OrBerebi/Logots_V2/knowledge/functions/initiation.md

# initiation

MAIN GOAL — you are running the function "initiation": this robot has no
memory yet. Meet the plant in front of you for the first time: classify it and
deliver the information that initiates the memory documents. Success = finish
carrying a classification you actually saw (medium or high confidence), or an
honest report of why it was not possible. HOW to get there — when to look,
when to move, when to stop — is entirely your decision; the ACTIONS list tells
you what each tool does.
