OrBerebi/Logots_V2/docs/robot1_system/header_pinouts.png

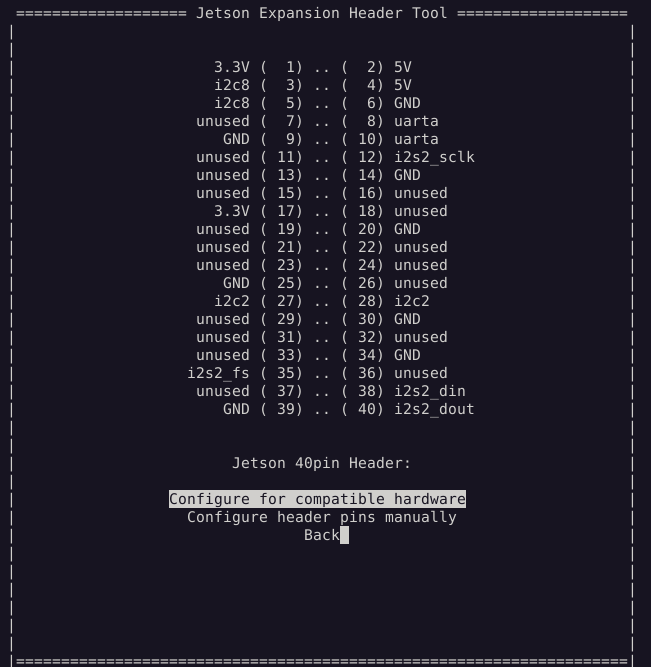
docs/robot1_system/header_pinouts.png
