OrBerebi/Logots_V2/src/logots_ui.py

#!/usr/bin/env python3
"""
Logots Robot Control — Full Monitoring GUI
Panels: Drive + Arm  |  IMU orientation  |  Audio waveform  |  Video feed
"""

import tkinter as tk
from tkinter import filedialog, messagebox
import atexit
import math
import signal
import sys
import time
import threading
import subprocess
import os
import tempfile
import csv
import queue
import json
import collections
import io
import base64
import struct
from datetime import datetime
from http.server import BaseHTTPRequestHandler, ThreadingHTTPServer

# Base64 color JPEG fields exceed the default 128 KB csv field limit
csv.field_size_limit(min(sys.maxsize, 2**31 - 1))

import numpy as np

import matplotlib
matplotlib.use('TkAgg')
from matplotlib.figure import Figure
from matplotlib.backends.backend_tkagg import FigureCanvasTkAgg
from mpl_toolkits.mplot3d.art3d import Poly3DCollection

# ── Optional deps ─────────────────────────────────────────────────────────────
try:
    from smbus2 import SMBus, i2c_msg
    SMBUS2 = True
except ImportError:
    try:
        import smbus
        SMBUS2 = False
    except ImportError:
        SMBUS2 = None

try:
    import sounddevice as sd
    AUDIO_OK = True
except ImportError:
    AUDIO_OK = False


from PIL import Image, ImageTk

try:
    import cv2
    CV2_OK = True
except ImportError:
    CV2_OK = False

# ── Hardware constants ────────────────────────────────────────────────────────
API_PORT      = 8787
ARDUINO_ADDR  = 0x08
ENC_PKT_HDR   = 0xE5   # encoder read-back packet: hdr, int32 left, int32 right, sum8
ENC_PKT_LEN   = 10     # (see requestEvent() in the firmware)
IMU_I2C_BUS   = 7
MPU_ADDR      = 0x68
AUDIO_RATE    = 16000
AUDIO_BLOCK   = 512

# ── Capture loop rate ─────────────────────────────────────────────────────────
# Sensory-capture / recording tick rate. The loop is drift-compensated (it waits
# PERIOD_MS minus however long the tick's work took), so the ACTUAL rate tracks
# TARGET_FPS as long as the per-tick work fits inside PERIOD_MS. 10 FPS (100 ms)
# is sustainable on the Jetson, whose per-tick work is ~45-90 ms.
TARGET_FPS = 10
PERIOD_MS  = int(round(1000 / TARGET_FPS))   # 100 ms per tick

# Camera capture rate. The FIFO reader keeps only the latest frame, so the camera
# only needs to feed the ~10 FPS loop — running it at the sensor's full 30 FPS just
# burns ISP + videoconvert + FIFO bandwidth on frames that get discarded. A little
# headroom above TARGET_FPS keeps the displayed frame fresh. Drop to match if you
# want maximum savings.
CAMERA_FPS = 15

PWR_MGMT_1 = 0x6B;  CONFIG_REG = 0x1A
GYRO_CFG   = 0x1B;  ACCEL_CFG  = 0x1C;  ACCEL_CFG2 = 0x1D
ACCEL_OUT  = 0x3B;  GYRO_OUT   = 0x43
ACCEL_SCALE = 16384.0;  GYRO_SCALE = 131.0

# ── Position estimation ───────────────────────────────────────────────────────
# Primary model (2026-10-03): per-tick forward distance comes from real encoder counts
# (JGA25-370 Hall encoders), not a PWM model — see PositionEstimator below. Direction still
# comes from the IMU yaw (no encoder-based heading — the two wheels' counts-per-rev already
# differ by ~2%, not reliable enough for differential heading on top of the IMU we already
# have). counts-per-rev and wheel diameter are from the 2026-10-03 bench test (5 hand-turns
# per wheel; wheel diameter measured at 2.78in outer).
LEFT_COUNTS_PER_REV  = 3286
RIGHT_COUNTS_PER_REV = 3208
WHEEL_DIAMETER_M      = 2.78 * 0.0254   # = 0.0706 m
WHEEL_CIRCUMFERENCE_M = math.pi * WHEEL_DIAMETER_M

# Fallback model, used only on a tick where the encoder read-back fails (see
# PositionEstimator.update()) — forward speed modelled as proportional to commanded average
# PWM. ROBOT_MAX_SPEED_MPS is still an uncalibrated GUESS; fine for the rare fallback tick,
# not a substitute for the encoder path above.
ROBOT_MAX_SPEED_MPS = 0.30            # forward speed at |PWM|=255 — GUESS, calibrate
K_V = ROBOT_MAX_SPEED_MPS / 255.0     # m/s per PWM unit

# Gyro-assisted straight-line trim (2026-10-03): live floor tests found the robot curves
# ~5-6°/s even at equal left_pwm=right_pwm, despite the two motors measuring roughly
# speed-matched on the (unloaded, wheels-raised) bench test — a real floor-load asymmetry.
# _send_motors() corrects this in software: whenever the commanded PWM is equal and
# nonzero, it locks the IMU yaw at that moment and trims one wheel proportionally to the
# yaw error each tick, on the wire only (self.left_pwm/right_pwm — the commanded intent used
# by PositionEstimator's PWM fallback, the CSV and the frame API — are untouched). The sign
# below (left wheel reduced / right increased for positive error) is a first guess from the
# 2026-10-03 curving direction (right wheel's path measured longer than left's — see
# CLAUDE.md) — if a straight-drive test still curves, or curves the other way, flip the sign
# in _straight_trim().
STRAIGHT_KP       = 3.0   # PWM counts of trim per degree of yaw error. Live-tested 2026-10-03:
                           # KP=3 cut drift from ~5.6°/s (uncorrected) to ~1.4°/s, reproduced
                           # twice. KP=6 was tried to tighten it further and instead went
                           # unstable (133° drift in 4s, worse than uncorrected) — reverted.
                           # Don't raise this without adding tick-by-tick error/trim logging
                           # first to see the oscillation (the IMU may also be noisier while
                           # actually driving — motor electrical noise/vibration — than at rest,
                           # which a higher P gain would amplify).
STRAIGHT_KI       = 0.4   # PWM counts of trim per (degree·second) of accumulated error —
                           # added 2026-10-03 to kill the P-only controller's steady-state
                           # residual (observed: robot visibly not quite straight, right wheel
                           # slightly ahead) without raising KP again.
STRAIGHT_I_MAX    = 40     # anti-windup clamp on the accumulated integral's contribution
STRAIGHT_MAX_TRIM = 60    # clamp, so a large transient error can't stall/reverse a wheel

# ── Palette ───────────────────────────────────────────────────────────────────
C_BG      = '#1e1e2e'
C_PANEL   = '#2a2a3e'
C_BORDER  = '#3a3a5a'
C_TEXT    = '#e0e0f0'
C_SUB     = '#7070a0'
C_BLUE    = '#1a7abf'
C_BLUE_HI = '#3498db'
C_GREEN   = '#27ae60'
C_RED     = '#c0392b'
C_AMBER   = '#e67e22'

# ── Madgwick AHRS ─────────────────────────────────────────────────────────────
class Madgwick:
    def __init__(self, beta=0.033):
        self.beta = beta
        self.q    = np.array([1.0, 0.0, 0.0, 0.0])

    def update_imu(self, gx, gy, gz, ax, ay, az, dt):
        q = self.q
        gx=math.radians(gx); gy=math.radians(gy); gz=math.radians(gz)
        norm=math.sqrt(ax*ax+ay*ay+az*az)
        if norm==0: return
        ax/=norm; ay/=norm; az/=norm
        _2q0=2*q[0];_2q1=2*q[1];_2q2=2*q[2];_2q3=2*q[3]
        _4q0=4*q[0];_4q1=4*q[1];_4q2=4*q[2];_8q1=8*q[1];_8q2=8*q[2]
        q0q0=q[0]*q[0];q1q1=q[1]*q[1];q2q2=q[2]*q[2];q3q3=q[3]*q[3]
        s0=_4q0*q2q2+_2q2*ax+_4q0*q1q1-_2q1*ay
        s1=_4q1*q3q3-_2q3*ax+4*q0q0*q[1]-_2q0*ay-_4q1+_8q1*q1q1+_8q1*q2q2+_4q1*az
        s2=4*q0q0*q[2]+_2q0*ax+_4q2*q3q3-_2q3*ay-_4q2+_8q2*q1q1+_8q2*q2q2+_4q2*az
        s3=4*q1q1*q[3]-_2q1*ax+4*q2q2*q[3]-_2q2*ay
        norm=math.sqrt(s0*s0+s1*s1+s2*s2+s3*s3)
        if norm>0: s0/=norm;s1/=norm;s2/=norm;s3/=norm
        qD0=0.5*(-q[1]*gx-q[2]*gy-q[3]*gz)-self.beta*s0
        qD1=0.5*( q[0]*gx+q[2]*gz-q[3]*gy)-self.beta*s1
        qD2=0.5*( q[0]*gy-q[1]*gz+q[3]*gx)-self.beta*s2
        qD3=0.5*( q[0]*gz+q[1]*gy-q[2]*gx)-self.beta*s3
        q[0]+=qD0*dt;q[1]+=qD1*dt;q[2]+=qD2*dt;q[3]+=qD3*dt
        self.q=q/math.sqrt(sum(x*x for x in q))

    def get_yaw_pitch_roll(self):
        q=self.q
        yaw  =math.degrees(math.atan2(2*(q[0]*q[3]+q[1]*q[2]),1-2*(q[2]*q[2]+q[3]*q[3])))
        pitch=math.degrees(math.asin(max(-1,min(1,2*(q[0]*q[2]-q[3]*q[1])))))
        roll =math.degrees(math.atan2(2*(q[0]*q[1]+q[2]*q[3]),1-2*(q[1]*q[1]+q[2]*q[2])))
        return yaw, pitch, roll

# ── IMU reader thread ─────────────────────────────────────────────────────────
class IMUReader(threading.Thread):
    CAL_N = 500

    def __init__(self):
        super().__init__(daemon=True)
        self.roll=self.pitch=self.yaw=0.0
        self.status      = 'starting'
        self.cal_prog    = 0
        self._stop       = threading.Event()
        self._bus        = None
        self._sample_buf  = []
        self._sample_lock = threading.Lock()

    def stop(self): self._stop.set()

    def drain_samples(self):
        with self._sample_lock:
            out, self._sample_buf = self._sample_buf, []
        return out

    def run(self):
        try:
            self._init_hw()
            self._calibrate()
            self.status = 'running'
            filt=Madgwick(); t_prev=time.time()
            while not self._stop.is_set():
                ax,ay,az=self._accel()
                gx,gy,gz=self._gyro()
                gx-=self._bg[0]; gy-=self._bg[1]; gz-=self._bg[2]
                t=time.time(); dt=t-t_prev; t_prev=t
                filt.update_imu(gx,gy,gz,ax,ay,az,dt)
                yaw,pitch,roll=filt.get_yaw_pitch_roll()
                yaw-=self._yo; pitch-=self._po; roll-=self._ro
                yaw=math.fmod(yaw+360,360)
                if pitch>180: pitch-=360
                if pitch<-180: pitch+=360
                if roll>180: roll-=360
                if roll<-180: roll+=360
                self.yaw=yaw; self.pitch=pitch; self.roll=roll
                with self._sample_lock:
                    self._sample_buf.append((yaw, pitch, roll))
                time.sleep(0.005)   # cap ~200Hz (2026-10-03) — this loop had no rate limit at
                # all, spinning as fast as the I2C bus allowed (likely 1000s of Hz) and
                # pegging a CPU core continuously; under the GIL that starves the main GUI
                # thread of scheduling time, which is why the capture tick's actual FPS was
                # sitting well under its 10Hz target even at rest. 200Hz is still far faster
                # than anything downstream needs (the 10Hz capture tick just drains whatever
                # accumulated; the Madgwick filter integrates fine at this rate).
        except Exception as e:
            self.status=f'error: {e}'

    def _init_hw(self):
        b = SMBus(IMU_I2C_BUS) if SMBUS2 else smbus.SMBus(IMU_I2C_BUS)
        self._bus=b
        b.write_byte_data(MPU_ADDR,PWR_MGMT_1,0x00); time.sleep(0.1)
        b.write_byte_data(MPU_ADDR,PWR_MGMT_1,0x01)
        b.write_byte_data(MPU_ADDR,CONFIG_REG, 0x02)
        b.write_byte_data(MPU_ADDR,ACCEL_CFG,  0x00)
        b.write_byte_data(MPU_ADDR,ACCEL_CFG2, 0x04)
        b.write_byte_data(MPU_ADDR,GYRO_CFG,   0x00)
        time.sleep(0.1)

    def _calibrate(self):
        self.status='calibrating'
        N=self.CAL_N
        sx=sy=sz=0.0
        for i in range(N):
            gx,gy,gz=self._gyro(); sx+=gx; sy+=gy; sz+=gz
            self.cal_prog=int(i/N*50)
        self._bg=(sx/N,sy/N,sz/N)
        filt=Madgwick(); t_prev=time.time()
        sy2=sp2=sr2=0.0
        for i in range(N):
            ax,ay,az=self._accel(); gx,gy,gz=self._gyro()
            gx-=self._bg[0]; gy-=self._bg[1]; gz-=self._bg[2]
            t=time.time(); filt.update_imu(gx,gy,gz,ax,ay,az,t-t_prev); t_prev=t
            y,p,r=filt.get_yaw_pitch_roll(); sy2+=y; sp2+=p; sr2+=r
            self.cal_prog=50+int(i/N*50)
        self._yo=sy2/N; self._po=sp2/N; self._ro=sr2/N

    def _s16(self,hi,lo):
        v=(hi<<8)|lo; return v-65536 if v>32767 else v

    def _accel(self):
        d=self._bus.read_i2c_block_data(MPU_ADDR,ACCEL_OUT,6)
        return (self._s16(d[0],d[1])/ACCEL_SCALE,
                self._s16(d[2],d[3])/ACCEL_SCALE,
                self._s16(d[4],d[5])/ACCEL_SCALE)

    def _gyro(self):
        d=self._bus.read_i2c_block_data(MPU_ADDR,GYRO_OUT,6)
        return (self._s16(d[0],d[1])/GYRO_SCALE,
                self._s16(d[2],d[3])/GYRO_SCALE,
                self._s16(d[4],d[5])/GYRO_SCALE)

# ── Position estimator ────────────────────────────────────────────────────────
class PositionEstimator:
    """Dead-reckons body (x, y) in metres from wheel encoders + IMU heading.

    Forward distance per tick is the average of each wheel's measured displacement
    (encoder count delta / that wheel's counts-per-rev · wheel circumference); heading θ
    comes from the IMU yaw, not the encoders (the two wheels' counts-per-rev already differ
    by ~2%, not precise enough for differential heading on top of the IMU we already have).
    Integrated each tick: x += d·cosθ, y += d·sinθ. Pure spins (L=+, R=−) average to ~0 net
    wheel displacement, so heading changes without translation.

    Falls back to the old PWM-speed model (v = k_v·(left_pwm+right_pwm)/2, integrated over
    dt) for any tick where the encoder read-back fails (enc_left/enc_right is None) — e.g. a
    bad I2C read. Once readings resume, the encoder delta is computed against the last good
    count, so no distance is lost across a brief gap; only that one tick's distance comes
    from the (less accurate) PWM model instead of being skipped outright."""

    def __init__(self, k_v=K_V,
                 left_counts_per_rev=LEFT_COUNTS_PER_REV,
                 right_counts_per_rev=RIGHT_COUNTS_PER_REV,
                 wheel_circumference_m=WHEEL_CIRCUMFERENCE_M):
        self.k_v = k_v
        self.left_counts_per_rev    = left_counts_per_rev
        self.right_counts_per_rev   = right_counts_per_rev
        self.wheel_circumference_m  = wheel_circumference_m
        self.reset()

    def reset(self):
        self.x = self.y = self.heading = 0.0
        self._t = None
        self._last_enc_left = self._last_enc_right = None

    def update(self, enc_left, enc_right, left_pwm, right_pwm, yaw_deg, now=None):
        now = now if now is not None else time.monotonic()
        have_enc = enc_left is not None and enc_right is not None
        if self._t is None:                 # first sample: seed time + heading only
            self._t = now; self.heading = yaw_deg
            if have_enc: self._last_enc_left, self._last_enc_right = enc_left, enc_right
            return
        dt = now - self._t; self._t = now
        if dt <= 0 or dt > 0.5: return      # guard stalls / first big gap
        if have_enc and self._last_enc_left is not None:
            dist_l = ((enc_left  - self._last_enc_left)  / self.left_counts_per_rev
                       * self.wheel_circumference_m)
            dist_r = ((enc_right - self._last_enc_right) / self.right_counts_per_rev
                       * self.wheel_circumference_m)
            forward = (dist_l + dist_r) / 2.0
        else:                                # encoder read failed this tick: PWM fallback
            forward = self.k_v * (left_pwm + right_pwm) / 2.0 * dt
        if have_enc:
            self._last_enc_left, self._last_enc_right = enc_left, enc_right
        th = math.radians(yaw_deg)
        self.x += forward * math.cos(th)
        self.y += forward * math.sin(th)
        self.heading = yaw_deg

# ── Audio reader ──────────────────────────────────────────────────────────────
class AudioReader:
    def __init__(self):
        self._stream   = None
        self.status    = 'stopped'
        self._drain_buf  = []
        self._drain_lock = threading.Lock()

    def start(self):
        if not AUDIO_OK:
            self.status='unavailable'; return
        try:
            self._stream=sd.InputStream(samplerate=AUDIO_RATE,channels=1,
                                         blocksize=AUDIO_BLOCK,callback=self._cb)
            self._stream.start(); self.status='running'
        except Exception as e:
            self.status=f'error: {e}'

    def _cb(self,indata,frames,t,status):
        with self._drain_lock:
            self._drain_buf.extend(indata[:, 0].tolist())

    def drain_samples(self):
        with self._drain_lock:
            out, self._drain_buf = self._drain_buf, []
        return out

    def stop(self):
        if self._stream:
            try: self._stream.stop(); self._stream.close()
            except: pass

# ── Action reader (executes functions-layer decisions from :8788) ──────────────
class ActionReader(threading.Thread):
    """Ask #3 in docs/v2_architecture/functions_layer_report.md: polls Asaf's
    functions-layer ActionsEndpoint (GET :8788/latest_action, src/actions.py)
    and executes approach_plant's left_pwm/right_pwm/duration_s on the motors,
    the same way the joystick does (sets gui.left_pwm/right_pwm; _send_motors()
    ticks them out over I2C). Completion (ask #2) is reported back over the
    real contract actions.py already implements — POST :8788/action_done with
    {"action_id", "pos_x", "pos_y", "heading"} — which is what functions.py's
    wait_for_done()/endpoint.completion() actually waits on (NOT the :8787
    frame API; an earlier version of this reader used a `last_action_id` field
    there, but that doesn't satisfy the contract actions.py implements)."""

    POLL_S = 0.2

    def __init__(self, gui, host='localhost', port=8788):
        super().__init__(daemon=True)
        self.gui   = gui
        self.host  = host
        self.port  = port
        self.get_url  = f'http://{host}:{port}/latest_action'
        self.post_url = f'http://{host}:{port}/action_done'
        self._stop_evt = threading.Event()
        self._seen_id  = None

    def stop(self):
        self._stop_evt.set()

    def run(self):
        import urllib.request
        while not self._stop_evt.is_set():
            time.sleep(self.POLL_S)
            try:
                with urllib.request.urlopen(self.get_url, timeout=1.0) as resp:
                    action = json.loads(resp.read())
            except Exception:
                continue  # functions.py not running yet, or no action published yet
            aid = action.get('action_id')
            if aid is None or aid == self._seen_id:
                continue
            self._seen_id = aid
            if action.get('action') == 'approach_plant' and not self.gui.sim_mode:
                self._drive(action)

    def _drive(self, action):
        import urllib.request
        args = action.get('args', {})
        try:
            l   = max(-255, min(255, int(args['left_pwm'])))
            r   = max(-255, min(255, int(args['right_pwm'])))
            dur = max(0.0, float(args['duration_s']))
        except (KeyError, TypeError, ValueError) as e:
            print(f"[actions] bad approach_plant args {args}: {e}", flush=True)
            return
        aid = action['action_id']
        print(f"[actions] approach_plant #{aid} L={l} R={r} for {dur}s", flush=True)
        self.gui.left_pwm, self.gui.right_pwm = l, r
        time.sleep(dur)
        self.gui.left_pwm = self.gui.right_pwm = 0
        pos = self.gui._pos_est
        report = {'action_id': aid, 'pos_x': pos.x, 'pos_y': pos.y, 'heading': pos.heading}
        try:
            req = urllib.request.Request(self.post_url, data=json.dumps(report).encode(),
                                         headers={'Content-Type': 'application/json'}, method='POST')
            urllib.request.urlopen(req, timeout=1.0).close()
            print(f"[actions] approach_plant #{aid} done, reported pos "
                  f"({pos.x:.2f}, {pos.y:.2f}) heading {pos.heading:.0f}°", flush=True)
        except Exception as e:
            print(f"[actions] failed to POST /action_done for #{aid}: {e}", flush=True)

# ── Listener status (what functions.py --listen is doing, from :8788/status) ───
class ListenerStatusReader(threading.Thread):
    """Polls the voice listener's GET :8788/status for the header's LLM/MIC
    indicators and the audio panel's ACTION row. Its own thread: ActionReader
    sleeps through every drive, and the capture tick must never wait on HTTP."""

    POLL_S = 0.2

    def __init__(self, host='localhost', port=8788):
        super().__init__(daemon=True)
        self.url = f'http://{host}:{port}/status'
        self.stage = 'off'       # 'off' = nothing answering on :8788
        self.last_action = None

    def run(self):
        import urllib.request
        while True:
            try:
                with urllib.request.urlopen(self.url, timeout=1.0) as resp:
                    status = json.loads(resp.read())
                self.stage = status.get('stage', 'off')
                self.last_action = status.get('last_action') or self.last_action
            except Exception:
                self.stage = 'off'
            time.sleep(self.POLL_S)

# ── Camera reader ─────────────────────────────────────────────────────────────
class CameraReader(threading.Thread):
    W, H = 640, 480
    FRAME_BYTES = W * H * 3

    def __init__(self):
        super().__init__(daemon=True)
        self._frame = None
        self._lock  = threading.Lock()
        self.status = 'starting'
        self._stop  = threading.Event()
        self._proc  = None

    def stop(self):
        self._stop.set()
        if self._proc:
            try: self._proc.terminate()
            except: pass

    def get_frame(self):
        with self._lock:
            return self._frame.copy() if self._frame is not None else None

    FIFO = '/tmp/logots_camera.fifo'

    def run(self):
        # Use a FIFO so frame bytes are fully separated from gst-launch text output
        if os.path.exists(self.FIFO):
            os.unlink(self.FIFO)
        os.mkfifo(self.FIFO)

        pipeline = (
            f'nvarguscamerasrc sensor-id=0 '
            f'! "video/x-raw(memory:NVMM),width={self.W},height={self.H},framerate={CAMERA_FPS}/1" '
            f'! nvvidconv '
            f'! "video/x-raw,format=BGRx" '
            f'! videoconvert '
            f'! "video/x-raw,format=BGR" '
            f'! filesink location={self.FIFO}'
        )
        env = os.environ.copy()
        env['EGL_PLATFORM'] = 'surfaceless'
        try:
            self._proc = subprocess.Popen(
                f'gst-launch-1.0 -q {pipeline}',
                shell=True, stdout=subprocess.DEVNULL, stderr=subprocess.DEVNULL,
                env=env
            )
            with open(self.FIFO, 'rb') as fifo:
                self.status = 'running'
                while not self._stop.is_set():
                    raw = fifo.read(self.FRAME_BYTES)
                    if len(raw) != self.FRAME_BYTES:
                        break
                    frame = np.frombuffer(raw, dtype=np.uint8).reshape(self.H, self.W, 3)
                    with self._lock:
                        self._frame = frame
        except Exception as e:
            self.status = f'error: {e}'
            return
        self.status = 'stopped'

# ── 3-D board geometry ────────────────────────────────────────────────────────
_BV = np.array([[-0.8,-1.5,-0.1],[0.8,-1.5,-0.1],[0.8,1.5,-0.1],[-0.8,1.5,-0.1],
                [-0.8,-1.5, 0.1],[0.8,-1.5, 0.1],[0.8,1.5, 0.1],[-0.8,1.5, 0.1]])
_BF = [[0,1,2,3],[4,5,6,7],[4,5,1,0],[6,7,3,2],[0,3,7,4],[1,2,6,5]]
_FC = [C_BLUE,C_BLUE,C_GREEN,C_GREEN,C_RED,C_RED]

def _rotmat(r,p,y):
    r=math.radians(r); p=math.radians(p); y=math.radians(y)
    Rx=np.array([[1,0,0],[0,math.cos(r),-math.sin(r)],[0,math.sin(r),math.cos(r)]])
    Ry=np.array([[math.cos(p),0,math.sin(p)],[0,1,0],[-math.sin(p),0,math.cos(p)]])
    Rz=np.array([[math.cos(y),-math.sin(y),0],[math.sin(y),math.cos(y),0],[0,0,1]])
    return Rz@Ry@Rx

# ── Frame encoding ────────────────────────────────────────────────────────────
def _encode_frame(frame_bgr):
    """BGR numpy (H×W×3) → color 640×640 JPEG base64 string."""
    img = Image.fromarray(frame_bgr[:, :, ::-1])
    img = img.resize((640, 640), Image.LANCZOS)
    buf = io.BytesIO()
    img.save(buf, format='JPEG', quality=70)
    return base64.b64encode(buf.getvalue()).decode('utf-8')

def _decode_frame(b64):
    """base64 JPEG string → BGR numpy (H×W×3), or None if empty.
    Handles both old grayscale and new color recordings."""
    if not b64:
        return None
    img = Image.open(io.BytesIO(base64.b64decode(b64))).convert('RGB')
    return np.asarray(img)[:, :, ::-1]

# ── Recording manager ─────────────────────────────────────────────────────────
class RecordingManager:
    # Original columns — the minimal set required for a CSV to count as a Logots
    # recording (SimPlayer checks against this so pre-position recordings still load).
    CORE_FIELDNAMES = [
        'frame_id', 'timestamp', 'frame_data',
        'yaw', 'pitch', 'roll',
        'audio_samples',
        'left_pwm', 'right_pwm', 'pan_angle', 'tilt_angle',
    ]
    # pos_x/pos_y (metres) + heading (deg): dead-reckoning estimate, see PositionEstimator.
    FIELDNAMES = CORE_FIELDNAMES + ['pos_x', 'pos_y', 'heading']

    def __init__(self):
        self._active   = False
        self._queue    = queue.Queue(maxsize=300)
        self._thread   = None
        self._csv_path = None

    @property
    def active(self): return self._active

    def start(self):
        ts = datetime.now().strftime('%Y%m%d_%H%M%S')
        _repo = os.path.dirname(os.path.dirname(os.path.abspath(__file__)))
        out_dir = os.path.join(_repo, 'recordings', f'session_{ts}')
        os.makedirs(out_dir, exist_ok=True)
        self._csv_path = os.path.join(out_dir, f'session_{ts}.csv')
        self._active = True
        self._thread = threading.Thread(target=self._writer, daemon=True)
        self._thread.start()

    def stop(self):
        self._active = False
        self._queue.put(None)
        if self._thread:
            self._thread.join(timeout=15)

    def enqueue(self, frame: dict, frame_bgr):
        if not self._active: return
        try:
            self._queue.put_nowait((dict(frame), frame_bgr))
        except queue.Full:
            pass

    def _writer(self):
        with open(self._csv_path, 'w', newline='') as f:
            w = csv.DictWriter(f, fieldnames=self.FIELDNAMES)
            w.writeheader()
            while True:
                item = self._queue.get()
                if item is None:
                    break
                row, frame_bgr = item
                row['frame_data'] = _encode_frame(frame_bgr) if frame_bgr is not None else ''
                w.writerow(row)
                f.flush()

# ── Sim player ────────────────────────────────────────────────────────────────
class SimPlayer:
    """Replays a recorded session CSV row-by-row, paced by its timestamps
    so playback runs in real time regardless of the rate the recording
    actually achieved."""

    WAIT = 'wait'   # sentinel: current frame should be held, next row not due yet

    def __init__(self, csv_path):
        self.csv_path  = csv_path
        self.loop      = True
        self.row_index = 0
        self.n_skipped = 0
        self._pending    = None   # parsed (frame, decoded, bgr) not yet due
        self._pending_ts = None   # its recorded timestamp (datetime or None)
        try:                       # one-time line count for the SIM %-progress readout
            with open(csv_path, 'r', newline='') as f:
                self.total_rows = max(sum(1 for _ in f) - 1, 0)   # minus header
        except OSError:
            self.total_rows = 0
        self._open()

    def _open(self):
        self._file   = open(self.csv_path, 'r', newline='')
        self._reader = csv.DictReader(self._file)
        fields = self._reader.fieldnames or []
        if not set(RecordingManager.CORE_FIELDNAMES) <= set(fields):
            self._file.close()
            raise ValueError('not a Logots recording CSV')
        self.row_index    = 0     # restart the %-progress readout each pass
        self._wall_start = None   # monotonic time when this pass started
        self._rec_start  = None   # first row's recorded timestamp of this pass

    def next_frame(self):
        """Return the next (frame, decoded, frame_bgr) once its recorded
        timestamp is due, SimPlayer.WAIT while the current frame should be
        held, or None at end-of-file when loop is off. Malformed rows are
        skipped; rows without a parsable timestamp are due immediately."""
        if self._pending is None and not self._advance():
            return None
        if self._pending_ts is not None:
            now = time.monotonic()
            if self._wall_start is None:
                self._wall_start = now
                self._rec_start  = self._pending_ts
            due = (self._pending_ts - self._rec_start).total_seconds()
            if now - self._wall_start < due:
                return SimPlayer.WAIT
        out = self._pending
        self._pending = None
        return out

    def _advance(self):
        """Parse the next valid row into self._pending. False at EOF (no loop)."""
        while True:
            try:
                row = next(self._reader)
            except StopIteration:
                if not self.loop:
                    return False
                self._file.close()
                self._open()          # resets this pass's time origins
                continue
            self.row_index += 1
            try:
                self._pending = self._parse(row)
            except Exception:
                self.n_skipped += 1
                continue
            try:
                self._pending_ts = datetime.fromisoformat(self._pending[0]['timestamp'])
            except Exception:
                self._pending_ts = None
            return True

    def _parse(self, row):
        def arr(key):
            try:    return json.loads(row.get(key) or '[]')
            except Exception: return []
        def num(key, fallback):
            try:    return int(float(row.get(key)))
            except Exception: return fallback
        def fnum(key, fallback):            # float variant, for the position columns
            try:    return float(row.get(key))
            except Exception: return fallback
        yaw, pitch, roll = arr('yaw'), arr('pitch'), arr('roll')
        decoded = {
            'imu':        list(zip(yaw, pitch, roll)),
            'audio':      arr('audio_samples'),
            'left_pwm':   num('left_pwm', 0),
            'right_pwm':  num('right_pwm', 0),
            'pan_angle':  num('pan_angle', 0),
            'tilt_angle': num('tilt_angle', 90),
            'pos_x':      fnum('pos_x', 0.0),   # 0.0 when column absent (old CSVs)
            'pos_y':      fnum('pos_y', 0.0),
            'heading':    fnum('heading', 0.0),
        }
        frame = {
            'frame_id':      num('frame_id', self.row_index - 1),
            'timestamp':     row.get('timestamp') or '',
            'frame_data':    row.get('frame_data') or '',
            'yaw':           row.get('yaw') or '[]',
            'pitch':         row.get('pitch') or '[]',
            'roll':          row.get('roll') or '[]',
            'audio_samples': row.get('audio_samples') or '[]',
            'left_pwm':      decoded['left_pwm'],
            'right_pwm':     decoded['right_pwm'],
            'pan_angle':     decoded['pan_angle'],
            'tilt_angle':    decoded['tilt_angle'],
            'pos_x':         decoded['pos_x'],
            'pos_y':         decoded['pos_y'],
            'heading':       decoded['heading'],
        }
        return frame, decoded, _decode_frame(frame['frame_data'])

    def close(self):
        try: self._file.close()
        except Exception: pass

# ── Frame API server ──────────────────────────────────────────────────────────
class FrameServer:
    """Stdlib HTTP server exposing the GUI's latest_frame at GET /latest_frame.
    JPEG encoding for real mode happens lazily per request (cached by frame_id)
    so the 20 Hz tick never pays for it."""

    def __init__(self, gui, host='0.0.0.0', port=API_PORT):
        self.gui    = gui
        self._cache = (None, '')   # (frame_id, base64 jpeg)
        self._server = ThreadingHTTPServer((host, port), self._make_handler())
        threading.Thread(target=self._server.serve_forever, daemon=True).start()

    def _payload(self):
        gui = self.gui
        with gui._frame_lock:
            frame = dict(gui.latest_frame)
            bgr   = gui.latest_frame_bgr
            sim   = gui.sim_mode
        if not frame:
            return None
        if not frame.get('frame_data') and bgr is not None:
            fid, b64 = self._cache
            if fid != frame['frame_id']:
                b64 = _encode_frame(bgr)
                self._cache = (frame['frame_id'], b64)
            frame['frame_data'] = b64
        for k in ('yaw', 'pitch', 'roll', 'audio_samples'):
            try:    frame[k] = json.loads(frame.get(k) or '[]')
            except Exception: frame[k] = []
        frame['sim_mode'] = sim
        return frame

    def _make_handler(server_self):
        class Handler(BaseHTTPRequestHandler):
            def log_message(self, *a): pass
            def _send(self, code, obj):
                body = json.dumps(obj).encode('utf-8')
                self.send_response(code)
                self.send_header('Content-Type', 'application/json')
                self.send_header('Content-Length', str(len(body)))
                self.end_headers()
                self.wfile.write(body)
            def do_GET(self):
                if self.path.split('?')[0] != '/latest_frame':
                    self._send(404, {'error': 'unknown path, use /latest_frame'})
                    return
                try:
                    payload = server_self._payload()
                except Exception as e:
                    self._send(500, {'error': str(e)})
                    return
                if payload is None:
                    self._send(503, {'error': 'no frame yet'})
                else:
                    self._send(200, payload)
        return Handler

# ── Widget helpers ────────────────────────────────────────────────────────────
def _hline(p):
    tk.Frame(p,bg=C_BORDER,height=1).pack(fill='x',padx=16,pady=3)

def _lbl(p,txt,fg=C_SUB,font=('Courier',9),bg=C_BG,**kw):
    return tk.Label(p,text=txt,bg=bg,fg=fg,font=font,**kw)

def _plbl(p,txt,fg=C_SUB,font=('Courier',9),**kw):
    return tk.Label(p,text=txt,bg=C_PANEL,fg=fg,font=font,**kw)

def _vallbl(p,txt,fg=C_BLUE,width=0,**kw):
    kw.setdefault('padx',8); kw.setdefault('pady',4)
    return tk.Label(p,text=txt,bg=C_PANEL,fg=fg,font=('Courier',11,'bold'),
                    width=width,**kw)

def _btn(p,txt,color,cmd,**kw):
    return tk.Button(p,text=txt,bg=color,fg=C_TEXT,relief='flat',
                     font=('Courier',10,'bold'),padx=12,pady=3,command=cmd,
                     cursor='hand2',activebackground=color,activeforeground=C_TEXT,**kw)

# ── Main GUI ──────────────────────────────────────────────────────────────────
class RobotControlGUI:
    JOY_R = 108
    JOY_T = 20

    def __init__(self, root):
        self.root=root
        root.title('Logots — Robot Control')
        root.configure(bg=C_BG)
        root.resizable(False,False)

        self.joy_x=self.joy_y=0.0
        self.joy_dragging=False
        self.keys_held=set()
        self.left_pwm=self.right_pwm=0
        self.pan_angle=0     # -90…+90, 0 = camera facing front, + = left
        self.tilt_angle=90
        self.enc_left=self.enc_right=None   # cumulative encoder counts; None = no reading
        self._straight_target=None   # locked IMU yaw for the gyro straight-line trim, see _straight_trim()
        self._straight_integral=0.0  # accumulated yaw error for the trim's integral term
        self._straight_t=None        # time.monotonic() of the last _straight_trim() call

        self._pos_est   = PositionEstimator()
        self._pos_trail = collections.deque(maxlen=400)  # (x,y) points for the mini-map

        self._fps_ema     = 0.0    # smoothed actual capture rate (Hz)
        self._last_tick_t = None   # monotonic time of the previous tick start

        self.i2c=None; self.connected=False
        self._last_reconnect=0

        self._rec_manager  = RecordingManager()
        self._rec_frame_id = 0
        self.latest_frame     = {}
        self.latest_frame_bgr = None
        self.latest_decoded   = {'imu': [], 'audio': []}
        self._frame_lock      = threading.Lock()
        self._rms_ema         = 0.0

        self.sim_mode   = False
        self.sim_player = None
        self._sim_ended = False
        self._pre_sim_angles = (90, 90)

        self.imu_reader=None; self.audio_reader=None; self.camera_reader=None
        self._imu_poly=None; self._imu_live=False
        self.action_reader=None
        self.listener=None

        self._build_ui()
        self._bind_keys()
        self._start_sensors()
        try:
            self._frame_server = FrameServer(self)
        except Exception as e:
            print(f'[logots] frame API server not started: {e}')
            self._frame_server = None
        self.action_reader = ActionReader(self); self.action_reader.start()
        self.listener_status = ListenerStatusReader(); self.listener_status.start()
        self._start_listener()
        self.root.protocol('WM_DELETE_WINDOW',self._shutdown)
        # via after(): never interrupt a tick mid-I2C-write with the final motor-stop
        signal.signal(signal.SIGTERM,lambda *_: self.root.after(0,self._shutdown))
        self._loop()

    # ── Build UI ──────────────────────────────────────────────────────────────
    def _build_ui(self):
        self._hdr(); _hline(self.root)
        self._main_panels()

    def _hdr(self):
        f=tk.Frame(self.root,bg=C_BG)
        f.pack(fill='x',padx=16,pady=(12,0))
        _lbl(f,'LOGOTS  ROBOT CONTROL',fg=C_TEXT,font=('Courier',14,'bold')).pack(side='left')
        self.lbl_cs=_lbl(f,'⬤  DISCONNECTED',fg=C_RED,font=('Courier',9,'bold'))
        self.lbl_cs.pack(side='right')
        self.lbl_fps=_lbl(f,'FPS: --',fg=C_SUB,font=('Courier',9,'bold'))
        self.lbl_fps.pack(side='right',padx=(0,16))
        self.lbl_llm=_lbl(f,'⬤  LLM: --',fg=C_SUB,font=('Courier',9,'bold'))
        self.lbl_llm.pack(side='right',padx=(0,16))
        self.lbl_voice=_lbl(f,'⬤  MIC: --',fg=C_SUB,font=('Courier',9,'bold'))
        self.lbl_voice.pack(side='right',padx=(0,16))


    def _main_panels(self):
        f=tk.Frame(self.root,bg=C_BG)
        f.pack(padx=16,pady=4)
        # Original 2×2 grid of big blocks, unchanged in size/height — the former
        # full-width bottom status bar is now a sidebar to its left instead.
        SW=190; LW=480; RW=415; TH=430; BH=220; GAP=6  # LW/TH grown 2026-10-03 (were 375/310):
        # the enlarged 200px position map (was 118px) sits in a column beside the 244px-wide
        # joystick, and together with the pan/tilt sliders above it, that column no longer fit
        # in the old fixed width *or* height — p_ctrl's content was silently being clipped by
        # pack_propagate(False) on both axes, not failing to draw (p_audio shares LW and
        # p_imu shares TH for grid symmetry, so they grow a little too and just get more
        # padding — no layout change needed there)
        p_side  = tk.Frame(f,bg=C_BG,   width=SW,height=TH+GAP+BH)
        p_ctrl  = tk.Frame(f,bg=C_PANEL,width=LW,height=TH)
        p_imu   = tk.Frame(f,bg=C_PANEL,width=RW,height=TH)
        p_audio = tk.Frame(f,bg=C_PANEL,width=LW,height=BH)
        p_video = tk.Frame(f,bg=C_PANEL,width=RW,height=BH)
        for p in (p_side,p_ctrl,p_imu,p_audio,p_video):
            p.pack_propagate(False)
        p_side.grid( row=0,column=0,rowspan=2,padx=(0,GAP),sticky='nsew')
        p_ctrl.grid( row=0,column=1,padx=(0,GAP),pady=(0,GAP),sticky='nsew')
        p_imu.grid(  row=0,column=2,pady=(0,GAP),sticky='nsew')
        p_audio.grid(row=1,column=1,padx=(0,GAP),sticky='nsew')
        p_video.grid(row=1,column=2,sticky='nsew')
        self._side_panel(p_side)
        self._ctrl_panel(p_ctrl)
        self._audio_panel(p_audio)
        self._imu_panel(p_imu)
        self._video_panel(p_video)

    # ── Control panel ─────────────────────────────────────────────────────────
    def _ctrl_panel(self,parent):
        p=parent
        _plbl(p,'DRIVE  &  CAM',font=('Courier',9,'bold')).pack(pady=(8,4))
        row=tk.Frame(p,bg=C_PANEL); row.pack(padx=10,pady=(0,8))
        self._joystick(row)
        rc=tk.Frame(row,bg=C_PANEL); rc.pack(side='left')   # sliders on top, map below
        sl=tk.Frame(rc,bg=C_PANEL); sl.pack(side='top')
        self._cam_sliders(sl)
        self._position_map(rc)

    def _joystick(self,parent):
        sz=(self.JOY_R+14)*2
        self.joy_cv=tk.Canvas(parent,width=sz,height=sz,bg=C_PANEL,highlightthickness=0)
        self.joy_cv.pack(side='left',padx=(4,10))
        self._draw_joy()
        self.joy_cv.bind('<ButtonPress-1>',  self._jp)
        self.joy_cv.bind('<B1-Motion>',      self._jm)
        self.joy_cv.bind('<ButtonRelease-1>',self._jr)

    def _draw_joy(self):
        cv=self.joy_cv; R=self.JOY_R; tr=self.JOY_T; cx=cy=R+14
        cv.delete('all')
        cv.create_oval(cx-R,cy-R,cx+R,cy+R,fill='#16162a',outline=C_BORDER,width=2)
        for f in (.5,1.): r2=R*f; cv.create_oval(cx-r2,cy-r2,cx+r2,cy+r2,outline=C_BORDER,fill='')
        cv.create_line(cx-R+8,cy,cx+R-8,cy,fill=C_BORDER)
        cv.create_line(cx,cy-R+8,cx,cy+R-8,fill=C_BORDER)
        mr=R-tr-2; tx=cx+self.joy_x*mr; ty=cy-self.joy_y*mr
        g=tr+7; cv.create_oval(tx-g,ty-g,tx+g,ty+g,fill='#0d2a40',outline='')
        fc=C_BLUE_HI if self.joy_dragging else C_BLUE
        cv.create_oval(tx-tr,ty-tr,tx+tr,ty+tr,fill=fc,outline='#5bb3e8')
        cv.create_oval(tx-4,ty-4,tx+4,ty+4,fill='#cce8ff',outline='')
        for txt,x,y in [('FWD',cx,cy-R+8),('BWD',cx,cy+R-8),('L',cx-R+8,cy),('R',cx+R-8,cy)]:
            cv.create_text(x,y,text=txt,fill=C_SUB,font=('Courier',7))

    def _jp(self,e):
        if self.sim_mode: return
        self.joy_dragging=True;  self._jxy(e.x,e.y)
    def _jm(self,e):
        if self.sim_mode: return
        self._jxy(e.x,e.y)
    def _jr(self,e):
        if self.sim_mode: return
        self.joy_dragging=False; self.joy_x=self.joy_y=0.0
        self._pwm(); self._draw_joy()
    def _jxy(self,mx,my):
        cx=cy=self.JOY_R+14; dx,dy=mx-cx,my-cy
        lim=self.JOY_R-self.JOY_T-2; d=math.hypot(dx,dy)
        if d>lim: dx=dx/d*lim; dy=dy/d*lim
        self.joy_x=dx/lim; self.joy_y=-dy/lim
        self._pwm(); self._draw_joy()

    def _cam_sliders(self,parent):
        # pan: -45…+45 (GUI-limited, 2026-10-03; firmware still accepts -90…+90) (0 = front,
        # + = left); tilt: 0…180
        for attr,label,top,bot,init,top_txt,bot_txt in [
                ('pan', 'PAN', 45, -45,0, 'L 45°','R 45°'),
                ('tilt','TILT',180,0,  90,'180°', '0°')]:
            f=tk.Frame(parent,bg=C_PANEL); f.pack(side='left',padx=2)
            _plbl(f,label,font=('Courier',8,'bold')).pack(pady=(4,0))
            _plbl(f,top_txt,font=('Courier',7)).pack()
            var=tk.IntVar(value=init)
            setattr(self,f'{attr}_var',var)
            tk.Scale(f,from_=top,to=bot,variable=var,orient='vertical',
                     length=120,width=16,bg=C_PANEL,fg=C_TEXT,troughcolor='#16162a',
                     activebackground=C_BLUE_HI,highlightthickness=0,bd=0,
                     sliderrelief='flat',sliderlength=20,showvalue=True,
                     command=lambda v,a=attr:None if self.sim_mode
                             else setattr(self,f'{a}_angle',int(v))).pack()
            _plbl(f,bot_txt,font=('Courier',7)).pack(pady=(0,4))

    # ── Position mini-map ─────────────────────────────────────────────────────
    POS_MAP        = 200   # canvas size (px), enlarged 2026-10-03 (was 118, "too small")
    POS_MAP_PX_PER_M = 28  # fixed scale — ~±3.6m visible each direction from the robot

    POS_MAP_N_GRID = 10   # pool size per axis — more than the ~9 gridlines ever visible at once

    def _position_map(self,parent):
        _plbl(parent,'POSITION (m)',font=('Courier',7,'bold')).pack(pady=(2,0))
        cv=tk.Canvas(parent,width=self.POS_MAP,height=self.POS_MAP,
                     bg='#16162a',highlightthickness=1,highlightbackground=C_BORDER)
        cv.pack(pady=(1,0))
        self.pos_cv=cv
        # Pre-create a fixed pool of canvas items, updated in place every redraw via
        # coords()/itemconfig() instead of delete()+create() — found 2026-10-03 that
        # recreating ~16 canvas text items cost ~65ms total on this system (each
        # create_text() ~4ms), blowing most of the capture tick's 100ms budget and dragging
        # FPS from 10 down to ~5. Updating pre-existing items costs ~0.02ms each instead.
        # Creation order here also fixes the stacking order permanently (grid under trail
        # under arrow/dot), so it never needs re-asserting on redraw.
        N=self.POS_MAP_N_GRID
        self._map_vlines =[cv.create_line(0,0,0,self.POS_MAP,fill='#25253a') for _ in range(N)]
        self._map_hlines =[cv.create_line(0,0,self.POS_MAP,0,fill='#25253a') for _ in range(N)]
        self._map_vlabels=[cv.create_text(0,0,text='',fill=C_SUB,font=('Courier',6),anchor='nw') for _ in range(N)]
        self._map_hlabels=[cv.create_text(0,0,text='',fill=C_SUB,font=('Courier',6),anchor='nw') for _ in range(N)]
        self._map_origin = cv.create_oval(0,0,0,0,outline=C_SUB,fill='',state='hidden')
        self._map_trail  = cv.create_line(0,0,0,0,fill=C_BLUE,width=1,state='hidden')
        self._map_arrow  = cv.create_line(0,0,0,0,fill=C_GREEN,width=3,arrow='last',arrowshape=(10,12,5))
        self._map_dot    = cv.create_oval(0,0,0,0,fill=C_BLUE_HI,outline='')
        self._draw_pos_map()

    def _draw_pos_map(self):
        """Robot-centered top-down map (2026-10-03 redesign): the heading arrow stays fixed
        at the canvas center; the background (metre gridlines + trail) pans under it as the
        robot moves, like a radar/mini-map display, instead of the whole trail being
        auto-zoomed to fit. Fixed scale (POS_MAP_PX_PER_M) so the gridlines are always
        meaningful distance marks, not a shrinking/growing scale. +X right, +Y up on screen.
        Updates the item pool created in _position_map() in place — see that method's
        comment for why (performance)."""
        cv=self.pos_cv; S=self.POS_MAP; PPM=self.POS_MAP_PX_PER_M
        pts=list(self._pos_trail)
        rx,ry = pts[-1] if pts else (0.0,0.0)   # robot's current world position
        heading = self.latest_frame.get('heading',0.0) if self.latest_frame else 0.0
        cxp=cyp=S/2   # the robot is always drawn here — canvas center never moves
        def to_px(wx,wy):
            return cxp+(wx-rx)*PPM, cyp-(wy-ry)*PPM   # world -> screen, robot-centered
        # metre gridlines, panning with the robot — origin's axis line drawn brighter so you
        # can always tell which way back to the start (session/recording origin) is
        half_m = (S/2)/PPM
        xs = list(range(math.floor(rx-half_m), math.ceil(rx+half_m)+1))
        ys = list(range(math.floor(ry-half_m), math.ceil(ry+half_m)+1))
        for i,item in enumerate(self._map_vlines):
            if i<len(xs):
                gx=xs[i]; px,_=to_px(gx,ry)
                cv.coords(item,px,0,px,S); cv.itemconfig(item,fill=(C_SUB if gx==0 else '#25253a'),state='normal')
            else:
                cv.itemconfig(item,state='hidden')
        for i,item in enumerate(self._map_vlabels):
            if i<len(xs) and xs[i]!=0:
                px,_=to_px(xs[i],ry)
                cv.coords(item,px+2,2); cv.itemconfig(item,text=str(xs[i]),state='normal')
            else:
                cv.itemconfig(item,state='hidden')
        for i,item in enumerate(self._map_hlines):
            if i<len(ys):
                gy=ys[i]; _,py=to_px(rx,gy)
                cv.coords(item,0,py,S,py); cv.itemconfig(item,fill=(C_SUB if gy==0 else '#25253a'),state='normal')
            else:
                cv.itemconfig(item,state='hidden')
        for i,item in enumerate(self._map_hlabels):
            if i<len(ys) and ys[i]!=0:
                _,py=to_px(rx,ys[i])
                cv.coords(item,2,py+2); cv.itemconfig(item,text=str(ys[i]),state='normal')
            else:
                cv.itemconfig(item,state='hidden')
        # origin marker (session/recording start), only shown while it's in view
        ox,oy=to_px(0.0,0.0)
        if 0<=ox<=S and 0<=oy<=S:
            cv.coords(self._map_origin,ox-3,oy-3,ox+3,oy+3); cv.itemconfig(self._map_origin,state='normal')
        else:
            cv.itemconfig(self._map_origin,state='hidden')
        # trail polyline, in the same panning frame — older points scroll off-canvas
        # naturally as the robot moves on, newest end always meets the center arrow
        if len(pts)>=2:
            flat=[]
            for wx,wy in pts:
                px,py=to_px(wx,wy); flat+=[px,py]
            cv.coords(self._map_trail,*flat); cv.itemconfig(self._map_trail,state='normal')
        else:
            cv.itemconfig(self._map_trail,state='hidden')
        # heading arrow — always at the fixed canvas center
        th=math.radians(heading)
        ax=cxp+24*math.cos(th); ay=cyp-24*math.sin(th)
        cv.coords(self._map_arrow,cxp,cyp,ax,ay)
        cv.coords(self._map_dot,cxp-4,cyp-4,cxp+4,cyp+4)

    # ── Audio panel ───────────────────────────────────────────────────────────
    def _audio_panel(self,parent):
        p=parent
        h=tk.Frame(p,bg=C_PANEL); h.pack(fill='x',padx=8,pady=(6,2))
        _plbl(h,'AUDIO INPUT',font=('Courier',9,'bold')).pack(side='left')
        self.lbl_as=_plbl(h,'',font=('Courier',8),fg=C_AMBER); self.lbl_as.pack(side='right')
        self.wav_cv=tk.Canvas(p,width=356,height=90,bg='#16162a',highlightthickness=0)
        self.wav_cv.pack(padx=8,pady=(0,4))
        self._wave_idle()
        br=tk.Frame(p,bg=C_PANEL); br.pack(fill='x',padx=8,pady=(0,4))
        _plbl(br,'RMS',font=('Courier',8)).pack(side='left')
        self.rms_cv=tk.Canvas(br,width=286,height=8,bg='#16162a',highlightthickness=0)
        self.rms_cv.pack(side='left',padx=6)
        ar=tk.Frame(p,bg=C_PANEL); ar.pack(fill='x',padx=8,pady=(0,8))
        _plbl(ar,'ACTION',font=('Courier',8)).pack(side='left',anchor='n')
        self.lbl_voice_action=_plbl(ar,'(no action yet)',font=('Courier',8),fg=C_SUB)
        self.lbl_voice_action.config(wraplength=410,justify='left')   # approach_plant's args run long
        self.lbl_voice_action.pack(side='left',padx=6)

    def _wave_idle(self):
        cv=self.wav_cv; w,h=356,90
        cv.delete('all')
        cv.create_line(0,h//2,w,h//2,fill=C_BORDER)
        cv.create_text(w//2,h//2,text='NO AUDIO',fill=C_SUB,font=('Courier',9))

    def _draw_wave(self,samples):
        cv=self.wav_cv; w,h=356,90; mid=h//2
        cv.delete('all')
        cv.create_line(0,mid,w,mid,fill=C_BORDER)
        n=len(samples)
        if n<2: return
        pts=[]
        for i,s in enumerate(samples):
            pts.extend([i*w/(n-1), mid-float(s)*mid*0.9*8])
        cv.create_line(*pts,fill=C_GREEN,width=1,smooth=True)

    def _draw_rms(self,rms):
        cv=self.rms_cv; cv.delete('all')
        fw=int(min(rms*64,1.0)*286)
        if fw>0:
            c=C_GREEN if rms<0.1 else (C_AMBER if rms<0.3 else C_RED)
            cv.create_rectangle(0,0,fw,8,fill=c,outline='')

    # ── IMU panel ─────────────────────────────────────────────────────────────
    def _imu_panel(self,parent):
        p=parent
        h=tk.Frame(p,bg=C_PANEL); h.pack(fill='x',padx=8,pady=(6,2))
        _plbl(h,'IMU ORIENTATION',font=('Courier',9,'bold')).pack(side='left')
        self.lbl_is=_plbl(h,'starting...',font=('Courier',8),fg=C_AMBER); self.lbl_is.pack(side='right')

        # Calibration placeholder (same footprint as the matplotlib figure)
        self._cal_frame=tk.Frame(p,bg=C_PANEL,width=407,height=240)
        self._cal_frame.pack_propagate(False); self._cal_frame.pack()
        _plbl(self._cal_frame,'Calibrating — keep IMU still',fg=C_AMBER,
              font=('Courier',10)).place(relx=.5,rely=.38,anchor='center')
        self._cal_cv=tk.Canvas(self._cal_frame,width=300,height=10,
                                bg='#16162a',highlightthickness=0)
        self._cal_cv.place(relx=.5,rely=.58,anchor='center')

        # Matplotlib 3D (packed after calibration)
        fig=Figure(figsize=(4.07,2.4),dpi=100,facecolor=C_PANEL)
        self._imu_ax=fig.add_subplot(111,projection='3d')
        ax=self._imu_ax; ax.set_facecolor(C_PANEL)
        for pn in (ax.xaxis.pane,ax.yaxis.pane,ax.zaxis.pane):
            pn.fill=False; pn.set_edgecolor('#333')
        ax.set_xlim(-2.5,2.5); ax.set_ylim(-2.5,2.5); ax.set_zlim(-2.5,2.5)
        for lbl,color in [('X',C_RED),('Y',C_GREEN),('Z',C_BLUE)]:
            getattr(ax,f'set_{lbl.lower()}label')(lbl,color=color,labelpad=2,fontsize=7)
        ax.tick_params(colors='#555',labelsize=6)
        fig.tight_layout(pad=0.4)
        self._imu_fig_cv=FigureCanvasTkAgg(fig,master=p)
        self._imu_wgt=self._imu_fig_cv.get_tk_widget()
        self._imu_wgt.configure(bg=C_PANEL,highlightthickness=0)

        # YPR labels (packed after calibration) — no manual colon-alignment
        # padding (they're separate side-by-side chips, not stacked, so it
        # only wasted width) and tighter internal padx so all three fit.
        self._ypr_frame=tk.Frame(p,bg=C_PANEL)
        self.lbl_r=_vallbl(self._ypr_frame,'Roll: +0.0°',fg=C_RED,padx=5)
        self.lbl_pi=_vallbl(self._ypr_frame,'Pitch: +0.0°',fg=C_GREEN,padx=5)
        self.lbl_y=_vallbl(self._ypr_frame,'Yaw: +0.0°',fg=C_BLUE,padx=5)
        for w in (self.lbl_r,self.lbl_pi,self.lbl_y): w.pack(side='left',padx=1)

    def _imu_go_live(self):
        self._cal_frame.pack_forget()
        self._imu_wgt.pack(padx=8)
        self._ypr_frame.pack(pady=(0,8))
        self._imu_live=True

    def _imu_redraw(self,roll,pitch,yaw):
        ax=self._imu_ax
        if self._imu_poly:
            try: self._imu_poly.remove()
            except: pass
        R=_rotmat(roll,pitch,yaw); v=_BV@R.T
        faces=[[v[i] for i in f] for f in _BF]
        self._imu_poly=Poly3DCollection(faces,facecolors=_FC,
                                         edgecolors='#111',linewidths=0.4,alpha=0.88)
        ax.add_collection3d(self._imu_poly)
        self._imu_fig_cv.draw_idle()

    # ── Video panel ───────────────────────────────────────────────────────────
    def _video_panel(self,parent):
        p=parent
        h=tk.Frame(p,bg=C_PANEL); h.pack(fill='x',padx=8,pady=(6,2))
        _plbl(h,'VIDEO FEED',font=('Courier',9,'bold')).pack(side='left')
        self.lbl_vs=_plbl(h,'no camera',font=('Courier',8),fg=C_AMBER); self.lbl_vs.pack(side='right')
        self.vid_cv=tk.Canvas(p,width=397,height=175,bg='#16162a',highlightthickness=0)
        self.vid_cv.pack(padx=8,pady=(0,8))
        self._vid_placeholder()

        # Label widget for live camera frames (hidden until camera available)
        self._vid_lbl=tk.Label(p,bg='#16162a',borderwidth=0)

    def _vid_placeholder(self):
        cv=self.vid_cv; w,h=397,175; cx,cy=w//2,h//2-10
        cv.create_rectangle(cx-42,cy-24,cx+42,cy+24,outline=C_BORDER,width=2)
        cv.create_oval(cx-15,cy-15,cx+15,cy+15,outline=C_BORDER,width=2)
        cv.create_oval(cx-5,cy-5,cx+5,cy+5,fill=C_BORDER,outline='')
        cv.create_rectangle(cx+30,cy-9,cx+42,cy-3,fill=C_BORDER,outline='')
        cv.create_text(w//2,h//2+30,text='STARTING CAMERA...',
                       fill=C_SUB,font=('Courier',8))

    def display_frame(self,bgr_frame):
        rgb=bgr_frame[:,:,::-1]   # BGR → RGB without cv2
        img=Image.fromarray(rgb).resize((397,175))
        self._photo=ImageTk.PhotoImage(img)
        self.vid_cv.delete('all')
        self.vid_cv.create_image(0,0,anchor='nw',image=self._photo)

    # ── Side panel (was the bottom status bar; now a left column) ──────────────
    def _side_panel(self,parent):
        p=parent
        def pk(w,pady=3):
            w.pack(fill='x',padx=10,pady=pady); return w
        self.lbl_lm =_vallbl(p,'L:  +000',fg=C_BLUE,width=12)
        self.lbl_rm =_vallbl(p,'R:  +000',fg=C_BLUE,width=12)
        # Encoder counts (EL/ER) are read each tick and feed PositionEstimator (see
        # "Arduino firmware protocol"/_read_encoders()) but are no longer shown in the GUI —
        # internal/debug data the user doesn't need to see (removed 2026-10-03 once the
        # position feature built on them was validated).
        self.lbl_pan=_vallbl(p,'PAN:+00°',fg=C_GREEN,width=12)
        self.lbl_tlt=_vallbl(p,'TLT:090°',fg=C_AMBER,width=12)
        self.lbl_pos=_vallbl(p,'X+0.00 Y+0.00',fg=C_BLUE_HI,width=15)
        self.lbl_hdg=_vallbl(p,'HDG:000°',fg=C_GREEN,width=12)
        pk(self.lbl_lm,(12,3)); pk(self.lbl_rm)
        pk(self.lbl_pan); pk(self.lbl_tlt)
        pk(self.lbl_pos); pk(self.lbl_hdg)
        pk(_btn(p,'⌖  POS',C_SUB,self._reset_pos),(8,4))
        _hline(p)
        self.btn_sim=_btn(p,'▶  SIM',C_SUB,self._toggle_sim); pk(self.btn_sim,(8,4))
        self.sim_loop_var=tk.BooleanVar(value=True)
        pk(tk.Checkbutton(p,text='LOOP',variable=self.sim_loop_var,bg=C_BG,fg=C_SUB,
                          font=('Courier',8),selectcolor=C_PANEL,activebackground=C_BG,
                          activeforeground=C_TEXT,highlightthickness=0),(0,4))
        self.btn_rec=_btn(p,'⚫  REC',C_SUB,self._toggle_rec); pk(self.btn_rec)
        _hline(p)
        pk(_btn(p,'■  STOP',C_RED,self._estop),(8,8))
        _hline(p)
        pk(_btn(p,'OFF',C_RED,self._off),(8,8))
        pk(_lbl(p,'⌨  W/S  A/D  SPACE',fg=C_SUB,font=('Courier',8),
                justify='center',wraplength=150),(4,4))
        self.lbl_tx=_lbl(p,'',fg=C_SUB,font=('Courier',8),
                         wraplength=150,justify='left',anchor='w')
        pk(self.lbl_tx,(8,4))

    # ── Keyboard ──────────────────────────────────────────────────────────────
    def _bind_keys(self):
        self.root.bind('<KeyPress>',  self._kd)
        self.root.bind('<KeyRelease>',self._ku)

    def _kd(self,e):
        if self.sim_mode: return
        self.keys_held.add(e.keysym.lower());  self._k2j()
    def _ku(self,e):
        if self.sim_mode: return
        self.keys_held.discard(e.keysym.lower()); self._k2j()
    def _k2j(self):
        if 'space' in self.keys_held:
            self.joy_x=self.joy_y=0.0
        else:
            self.joy_y=float('w' in self.keys_held)-float('s' in self.keys_held)
            self.joy_x=float('d' in self.keys_held)-float('a' in self.keys_held)
            self.joy_x=max(-1,min(1,self.joy_x)); self.joy_y=max(-1,min(1,self.joy_y))
        self._pwm(); self._draw_joy()

    # ── Motor mixing ──────────────────────────────────────────────────────────
    def _pwm(self):
        t=self.joy_y; turn=self.joy_x
        l=t+turn; r=t-turn; s=max(abs(l),abs(r),1.0)
        self.left_pwm=int(l/s*255); self.right_pwm=int(r/s*255)

    def _estop(self):
        self.joy_x=self.joy_y=0.0; self.left_pwm=self.right_pwm=0; self._draw_joy()

    def _off(self):
        """Closes the GUI app only — does NOT shut down the Jetson itself. Confirms first
        (closing stops the voice listener / frame API / actuation too)."""
        if not messagebox.askyesno('Close GUI', 'Close the robot control GUI?'):
            return
        self._shutdown()

    def _shutdown(self):
        """Every way out (OFF, window close, SIGTERM): flushes any active recording, zeros
        and sends a final motor-stop, stops the voice listener, then exits the process."""
        if self._rec_manager.active:
            self._rec_manager.stop()
        self.left_pwm = self.right_pwm = 0
        self._send_motors()
        self._stop_listener()
        self.root.destroy()
        sys.exit(0)

    def _start_listener(self):
        """One command starts the whole robot: launches the voice listener
        (`functions.py --listen`) as its own process — this one owns sensors/actuators
        and :8787, that one owns decisions and :8788. LISTEN=0 skips it, e.g. for a
        manual functions.py run, which needs :8788 for itself."""
        if os.environ.get('LISTEN','1') == '0':
            print('[voice] listener not started (LISTEN=0)',flush=True)
            return
        script = os.path.join(os.path.dirname(os.path.abspath(__file__)),'functions.py')
        try:
            self.listener = subprocess.Popen([sys.executable,script,'--listen'])
        except OSError as e:
            print(f'[voice] listener not started: {e}',flush=True)
            return
        atexit.register(self._stop_listener)   # also on Ctrl-C or an unhandled exception

    def _stop_listener(self):
        if self.listener is not None and self.listener.poll() is None:
            self.listener.terminate()          # it stops its own llama-server on the way out
            try:
                self.listener.wait(timeout=8)  # llama-server gets up to 5 s of this
            except subprocess.TimeoutExpired:
                self.listener.kill()

    def _reset_pos(self):
        """Zero the position estimate (origin = here). Blocked during sim."""
        if self.sim_mode: return
        self._pos_est.reset(); self._pos_trail.clear(); self._draw_pos_map()

    def _toggle_rec(self):
        if self._rec_manager.active:
            self._rec_manager.stop()
            self._rec_frame_id=0
            self.btn_rec.config(text='⚫  REC',bg=C_SUB)
        else:
            self._pos_est.reset(); self._pos_trail.clear()   # session starts at origin
            self._rec_manager.start()
            self.btn_rec.config(text='🔴  REC',bg=C_RED)

    def _toggle_sim(self):
        if self.sim_mode:                                   # Sim → Real
            self.sim_mode=False; self._sim_ended=False
            if self.sim_player:
                self.sim_player.close(); self.sim_player=None
            # Restore the pre-sim control state so the robot doesn't jump
            # to the last replayed values when real sends resume
            self.pan_angle,self.tilt_angle=self._pre_sim_angles
            self.pan_var.set(self.pan_angle); self.tilt_var.set(self.tilt_angle)
            self.joy_x=self.joy_y=0.0; self.left_pwm=self.right_pwm=0
            self._draw_joy()
            self._pos_est.reset(); self._pos_trail.clear()   # real odometry starts fresh
            self.btn_sim.config(text='▶  SIM',bg=C_SUB)
            self.btn_rec.config(state='normal')
            self.lbl_tx.config(text='')
            if self.connected: self.lbl_cs.config(text='⬤  CONNECTED',fg=C_GREEN)
            else:              self.lbl_cs.config(text='⬤  DISCONNECTED',fg=C_RED)
            return
        _repo=os.path.dirname(os.path.dirname(os.path.abspath(__file__)))
        path=filedialog.askopenfilename(
            title='Load recording CSV',
            initialdir=os.path.join(_repo,'recordings'),
            filetypes=[('Recording CSV','*.csv'),('All files','*.*')])
        if not path: return                                 # cancelled → stay Real
        try:
            player=SimPlayer(path)
        except Exception as e:
            self.lbl_tx.config(text=f'SIM load failed: {e}'[:44]); return
        if self._rec_manager.active: self._toggle_rec()
        self._pre_sim_angles=(self.pan_angle,self.tilt_angle)
        self.enc_left=self.enc_right=None   # not replayed
        self.sim_player=player; self.sim_mode=True; self._sim_ended=False
        self._pos_trail.clear()                             # replay draws the recorded path
        self.btn_sim.config(text='⏹  REAL',bg=C_BLUE)
        self.btn_rec.config(state='disabled')
        self.lbl_cs.config(text='⬤  SIM MODE',fg=C_BLUE_HI)

    # ── Arduino I2C ───────────────────────────────────────────────────────────
    def _conn(self):
        try:
            self.i2c=SMBus(1) if SMBUS2 else smbus.SMBus(1)
            if SMBUS2: self.i2c.read_byte(ARDUINO_ADDR)
            else: self.i2c.read_byte_data(ARDUINO_ADDR,0)
            self.connected=True
            self.lbl_cs.config(text='⬤  CONNECTED',fg=C_GREEN)
        except Exception:
            self.i2c=None

    def _disc(self):
        self.connected=False
        if self.i2c:
            try: self.i2c.close()
            except: pass
            self.i2c=None
        self.lbl_cs.config(text='⬤  DISCONNECTED',fg=C_RED)

    def _update_motor_labels(self,l,r,pa,ta):
        self.lbl_lm.config(text=f'L:  {l:+04d}')
        self.lbl_rm.config(text=f'R:  {r:+04d}')
        self.lbl_pan.config(text=f'PAN:{pa:+03d}°')
        self.lbl_tlt.config(text=f'TLT:{ta:03d}°')

    def _straight_trim(self, l, r):
        """Gyro-assisted straight-line correction (PI on yaw error) — see the STRAIGHT_KP/KI
        comments above. Only engages when commanded PWM is equal and nonzero (straight
        forward/backward); any turn (unequal PWM) or stop passes through untouched, drops the
        heading lock, and resets the integral so it doesn't carry over into the next straight
        run."""
        now = time.monotonic()
        if l != r or l == 0 or not self.imu_reader:
            self._straight_target = None
            self._straight_integral = 0.0
            self._straight_t = None
            return l, r
        yaw = self.imu_reader.yaw
        if self._straight_target is None:
            self._straight_target = yaw
            self._straight_integral = 0.0
            self._straight_t = now
            return l, r
        dt = now - self._straight_t; self._straight_t = now
        err = (yaw - self._straight_target + 180) % 360 - 180   # wrap to [-180,180]
        if 0 < dt < 0.5:   # guard stalls/big gaps, same as PositionEstimator
            self._straight_integral = max(-STRAIGHT_I_MAX, min(STRAIGHT_I_MAX,
                                           self._straight_integral + err*dt))
        trim = STRAIGHT_KP*err + STRAIGHT_KI*self._straight_integral
        trim = max(-STRAIGHT_MAX_TRIM, min(STRAIGHT_MAX_TRIM, trim))
        sign = 1 if l > 0 else -1    # reverse correction direction when backing up
        # Sign flipped 2026-10-03 live test: the first guess (l-=trim, r+=trim) was positive
        # feedback — a 4s drive swung heading +83° instead of holding it. This is the opposite.
        l2 = max(-255, min(255, l + int(round(sign*trim))))
        r2 = max(-255, min(255, r - int(round(sign*trim))))
        return l2, r2

    def _send_motors(self):
        l=self.left_pwm; r=self.right_pwm
        pa=self.pan_angle; ta=self.tilt_angle
        self._update_motor_labels(l,r,pa,ta)
        if not(self.connected and self.i2c):
            self.lbl_tx.config(text='(not sent)'); return
        # Positive PWM = forward on the wire too; each wheel's hardware direction is
        # corrected in the firmware's calibration block (LEFT/RIGHT_MOTOR_DIR). l/r are
        # further trimmed by _straight_trim() for the gyro-assisted straight-line correction
        # — self.left_pwm/right_pwm (the commanded intent) stay untouched for everything else
        # (PositionEstimator's PWM fallback, the CSV, the frame API).
        l,r = self._straight_trim(l,r)
        msg=f'{l},{r},{pa},{ta}\n'.encode()
        try:
            if SMBUS2:
                for off in range(0,len(msg),32):
                    self.i2c.i2c_rdwr(i2c_msg.write(ARDUINO_ADDR,list(msg[off:off+32])))
            else:
                self.i2c.write_i2c_block_data(ARDUINO_ADDR,0,list(msg))
            self.lbl_tx.config(text=f'TX {msg.decode().strip()}')
        except Exception:
            self._disc()

    def _read_encoders(self):
        # Cumulative wheel-encoder counts read back from the Arduino (smbus2 only).
        # A failed or bad read only blanks the readout — it never disconnects, so an
        # encoder problem can't take motor commands down with it.
        el=er=None
        if self.connected and self.i2c and SMBUS2:
            try:
                rd=i2c_msg.read(ARDUINO_ADDR,ENC_PKT_LEN)
                self.i2c.i2c_rdwr(rd)
                pkt=bytes(rd)
                if pkt[0]==ENC_PKT_HDR and sum(pkt[:-1])&0xFF==pkt[-1]:
                    el,er=struct.unpack('<ii',pkt[1:9])
            except Exception:
                pass
        self.enc_left,self.enc_right=el,er

    # ── Sensor startup ────────────────────────────────────────────────────────
    def _start_sensors(self):
        try:
            self.imu_reader=IMUReader(); self.imu_reader.start()
        except Exception as e:
            self.lbl_is.config(text=f'error: {e}',fg=C_RED)
        self.audio_reader=AudioReader(); self.audio_reader.start()
        self.camera_reader=CameraReader(); self.camera_reader.start()
        self._conn()

    # ── Capture loop (TARGET_FPS, drift-compensated) ──────────────────────────
    def _loop(self):
        t0 = time.monotonic()
        # Actual capture rate = 1 / (time between successive tick starts), smoothed.
        if self._last_tick_t is not None:
            dt = t0 - self._last_tick_t
            if dt > 0:
                inst = 1.0 / dt
                self._fps_ema = inst if self._fps_ema == 0 else 0.2*inst + 0.8*self._fps_ema
        self._last_tick_t = t0

        if self.sim_mode: self._tick_sim()
        else:             self._tick_real()
        self._update_imu_widgets()
        self._update_audio_widgets()
        self._update_video_widgets()
        self._update_position_widgets()
        if self._rec_manager.active and not self.sim_mode:
            self._rec_manager.enqueue(self.latest_frame, self.latest_frame_bgr)
        self._update_fps_label()
        self._update_voice_widgets()

        # Drift compensation: wait only the remainder of the period, so the actual
        # rate tracks TARGET_FPS instead of (work + fixed delay). If a tick overruns
        # PERIOD_MS we re-arm immediately (min 1 ms) and just run slower that tick.
        elapsed_ms = (time.monotonic() - t0) * 1000.0
        delay = max(1, int(round(PERIOD_MS - elapsed_ms)))
        self.root.after(delay, self._loop)

    def _tick_real(self):
        if not self.connected and time.time()-self._last_reconnect>3:
            self._last_reconnect=time.time()
            self._conn()
        self._send_motors()
        self._read_encoders()
        frame_bgr   = self.camera_reader.get_frame()    if self.camera_reader else None
        imu_samples = self.imu_reader.drain_samples()   if self.imu_reader    else []
        audio_samps = self.audio_reader.drain_samples() if self.audio_reader  else []
        yaw_now = (imu_samples[-1][0] if imu_samples
                   else (self.imu_reader.yaw if self.imu_reader else 0.0))
        self._pos_est.update(self.enc_left, self.enc_right,
                              self.left_pwm, self.right_pwm, yaw_now)
        frame = {
            'frame_id':      self._rec_frame_id,
            'timestamp':     datetime.now().isoformat(),
            'frame_data':    '',
            'yaw':           json.dumps([round(s[0],4) for s in imu_samples]),
            'pitch':         json.dumps([round(s[1],4) for s in imu_samples]),
            'roll':          json.dumps([round(s[2],4) for s in imu_samples]),
            'audio_samples': json.dumps([round(v,6) for v in audio_samps]),
            'left_pwm':      self.left_pwm,
            'right_pwm':     self.right_pwm,
            'pan_angle':     self.pan_angle,
            'tilt_angle':    self.tilt_angle,
            'pos_x':         round(self._pos_est.x, 4),
            'pos_y':         round(self._pos_est.y, 4),
            'heading':       round(self._pos_est.heading, 2),
        }
        with self._frame_lock:
            self.latest_frame     = frame
            self.latest_frame_bgr = frame_bgr
            self.latest_decoded   = {'imu': imu_samples, 'audio': audio_samps}
        self._rec_frame_id += 1

    def _tick_sim(self):
        if not self.sim_player: return
        self.sim_player.loop = self.sim_loop_var.get()
        nxt = self.sim_player.next_frame()
        if nxt is None:
            self._sim_ended = True
            self.lbl_tx.config(text='SIM ended')
            return
        if nxt is SimPlayer.WAIT:       # next row not due yet → hold this frame
            return
        self._sim_ended = False
        frame, decoded, frame_bgr = nxt
        with self._frame_lock:
            self.latest_frame     = frame
            self.latest_frame_bgr = frame_bgr
            self.latest_decoded   = decoded
        self._update_motor_labels(decoded['left_pwm'],decoded['right_pwm'],
                                  decoded['pan_angle'],decoded['tilt_angle'])
        # Animate the drive/cam controls from the recorded values
        self.pan_var.set(decoded['pan_angle'])
        self.tilt_var.set(decoded['tilt_angle'])
        l,r=decoded['left_pwm'],decoded['right_pwm']
        self.joy_y=max(-1.0,min(1.0,(l+r)/510.0))   # inverse of _pwm mixing
        self.joy_x=max(-1.0,min(1.0,(l-r)/510.0))
        self._draw_joy()
        sp=self.sim_player
        if sp.total_rows:
            pct=min(100,int(sp.row_index/sp.total_rows*100))
            txt=f'SIM {pct}%'
        else:
            txt=f'SIM row {sp.row_index}'
        if sp.n_skipped: txt+=f' ({sp.n_skipped} skipped)'
        self.lbl_tx.config(text=txt)

    # ── Monitoring widgets (driven by latest_frame snapshot in both modes) ────
    def _update_video_widgets(self):
        if self.sim_mode:
            if self.latest_frame_bgr is not None:
                self.display_frame(self.latest_frame_bgr)
            self.lbl_vs.config(text='SIM ended' if self._sim_ended else 'SIM',fg=C_BLUE_HI)
            return
        if not self.camera_reader: return
        st=self.camera_reader.status
        if st=='running':
            if self.latest_frame_bgr is not None:
                self.display_frame(self.latest_frame_bgr)
                self.lbl_vs.config(text='live',fg=C_GREEN)
        elif st=='stopped':
            self.lbl_vs.config(text='stopped',fg=C_AMBER)
        elif 'error' in str(st):
            self.lbl_vs.config(text=st[:28],fg=C_RED)

    def _update_imu_widgets(self):
        if self.sim_mode:
            self.lbl_is.config(text='SIM ended' if self._sim_ended else 'SIM',fg=C_BLUE_HI)
            if not self._imu_live: self._imu_go_live()
            self._imu_show_last()
            return
        if not self.imu_reader: return
        st=self.imu_reader.status
        if st=='calibrating':
            prog=self.imu_reader.cal_prog
            self.lbl_is.config(text=f'calibrating {prog}%',fg=C_AMBER)
            cv=self._cal_cv; cv.delete('all')
            cv.create_rectangle(0,0,int(prog*3),10,fill=C_BLUE,outline='')
        elif st=='running':
            self.lbl_is.config(text='running',fg=C_GREEN)
            if not self._imu_live: self._imu_go_live()
            self._imu_show_last()
        elif 'error' in str(st):
            self.lbl_is.config(text=st,fg=C_RED)

    def _imu_show_last(self):
        samples=self.latest_decoded.get('imu') or []
        if not samples: return                 # nothing new this tick → hold pose
        y,p,r=samples[-1]
        self._imu_redraw(r,p,y)
        self.lbl_r.config( text=f'Roll: {r:+.1f}°')
        self.lbl_pi.config(text=f'Pitch: {p:+.1f}°')
        self.lbl_y.config( text=f'Yaw: {y:+.1f}°')

    def _update_audio_widgets(self):
        if self.sim_mode:
            self.lbl_as.config(text='SIM ended' if self._sim_ended else 'SIM',fg=C_BLUE_HI)
            self._draw_audio()
            return
        if not self.audio_reader: return
        st=self.audio_reader.status
        if st=='running':
            self.lbl_as.config(text='live',fg=C_GREEN)
            self._draw_audio()
        elif 'error' in str(st):
            self.lbl_as.config(text=st[:28],fg=C_RED)
        elif st=='unavailable':
            self.lbl_as.config(text='sounddevice not installed',fg=C_RED)

    def _draw_audio(self):
        samples=self.latest_decoded.get('audio') or []
        if samples:
            arr=np.clip(np.asarray(samples,dtype=float),-0.5,0.5)  # reject glitches
            raw=float(np.sqrt(np.mean(arr**2)))
            self._rms_ema=0.25*raw+0.75*self._rms_ema   # smooth out spikes
            self._draw_wave(arr[-512:])
        else:
            self._draw_wave(np.zeros(512))
        self._draw_rms(self._rms_ema)

    def _update_position_widgets(self):
        """Read pos_x/pos_y/heading from the current snapshot (Real: live estimate,
        Sim: recorded values) and refresh the readout + mini-map."""
        fr=self.latest_frame or {}
        x=fr.get('pos_x',0.0); y=fr.get('pos_y',0.0); hdg=fr.get('heading',0.0)
        if not self._pos_trail or (x,y)!=self._pos_trail[-1]:
            self._pos_trail.append((x,y))
        self.lbl_pos.config(text=f'X{x:+05.2f} Y{y:+05.2f}')
        self.lbl_hdg.config(text=f'HDG:{int(hdg)%360:03d}°')
        self._draw_pos_map()

    def _update_fps_label(self):
        fps = self._fps_ema
        ok  = fps >= 0.9 * TARGET_FPS           # green when within 10% of target
        self.lbl_fps.config(text=f'FPS:{fps:4.1f}/{TARGET_FPS}',
                            fg=(C_GREEN if ok else C_AMBER))

    def _listener_stage(self):
        stage = self.listener_status.stage
        if stage == 'off' and self.listener is not None:   # ours, but nothing answering on :8788
            return 'loading' if self.listener.poll() is None else 'error'
        return stage

    def _update_voice_widgets(self):
        stage = self._listener_stage()
        llm_text, llm_fg = {
            'off':       ('LLM: off',     C_SUB),
            'loading':   ('LLM: loading', C_AMBER),
            'error':     ('LLM: error',   C_RED),
        }.get(stage, ('LLM: ready', C_GREEN))
        self.lbl_llm.config(text=f'⬤  {llm_text}', fg=llm_fg)

        voice_text, voice_fg = {
            'off':       ('MIC: off',       C_SUB),
            'loading':   ('MIC: loading',   C_AMBER),
            'error':     ('MIC: error',     C_RED),
            'asleep':    ('MIC: asleep',    C_SUB),
            'listening': ('MIC: listening', C_GREEN),
            'thinking':  ('MIC: thinking',  C_AMBER),
            'acting':    ('MIC: acting',    C_AMBER),
            'speaking':  ('MIC: speaking',  C_BLUE_HI),
            'initiation':('MIC: initiation',C_AMBER),   # busy with the routine, not listening
        }.get(stage, (f'MIC: {stage}', C_SUB))
        self.lbl_voice.config(text=f'⬤  {voice_text}', fg=voice_fg)

        last_action = self.listener_status.last_action
        if last_action:
            self.lbl_voice_action.config(text=last_action[:120], fg=C_GREEN)


# ── Entry point ───────────────────────────────────────────────────────────────
if __name__=='__main__':
    root=tk.Tk()
    app=RobotControlGUI(root)
    root.mainloop()
