OrBerebi/Logots_V2/(commit log)

2026-06-05 arduino firmware
    gets I2C interface from jetson and passes control signals to motors and servos.
2026-06-05 Add GUI, firmware, pinout, conda env, and full README
    - robot_control.py: full 4-panel GUI (drive+cam, IMU, audio, video)
    - logots_motor_control.ino: V2 firmware with independent pan/tilt servos
    - pinout.txt: updated with Arduino I2C + level shifter wiring
    - environment.yml: clean conda env spec (Python 3.10, numpy 2.x)
    - README.md: setup instructions, hardware table, protocol docs
    - CLAUDE.md: project context for Claude Code sessions
2026-06-05 Reframe project as PlantSitter — monitors and cares for home plants
2026-06-23 Add Gemma reflection + ASR investigation
    Self-contained experiment testing whether one local Gemma 4 E4B can replace
    both of Logots V1's AI stages — the reflective decision LLM (was cloud Claude
    Haiku) and ASR (was Whisper tiny) — via a single multimodal pipeline.
    - investigate.ipynb: narrated, self-contained walk-through with real outputs baked in
    - gemma_lab/ + run_all.py: same logic factored for scripted runs (mock + Gemma backends)
    - environment.yml + README: reproducible gemma-lab env and how-to-run
    - archive/docs: V1 system guide + architecture diagram the experiment references
    Findings: 100% valid JSON for reflection (~3s/call, well under V1's 20s budget)
    and ~7% WER for ASR; re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
2026-07-13 Add recording feature: staging-layer CSV output from all sensors
    - REC toggle button in status bar; sessions saved to recordings/session_*/
    - Each 20Hz tick assembles self.latest_frame (always-on, not just when recording)
    so downstream processing blocks can consume it without touching rec logic
    - IMUReader and AudioReader gain drain_samples() to capture all readings
    between frames as arrays, not just the latest snapshot
    - RecordingManager writer thread handles grayscale 640x640 JPEG base64
    encoding and CSV writes off the main thread (PIL, no cv2)
    - CSV schema matches Cat Sitter Data Architecture V2 staging layer
    - Added Cat Sitter Data Architecture V2.txt to repo
    - recordings/ added to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
2026-07-14 Add sim mode, frame API, and color recording
    - SIM/REAL toggle: replay a session CSV as if sampled live, paced by
    the recording's own timestamps (real-time playback); LOOP checkbox
    for wrap vs freeze at end-of-file
    - GUI monitoring widgets (IMU, waveform, video) now render from the
    latest_frame snapshot in both modes; joystick + pan/tilt sliders
    animate from recorded values during sim, user input blocked,
    pre-sim pan/tilt restored on exit
    - Frame API: built-in HTTP server (port 8787, stdlib) serving
    GET /latest_frame with lazy JPEG encode; new src/logots_api.py
    client (get_latest_frame) and src/api_demo.py video+audio example
    - Recordings now color JPEG (old grayscale CSVs stil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
2026-07-21 Add X/Y position estimation to the staging layer
    Estimate the robot body's 2D position live during operation via PWM
    dead-reckoning + IMU heading (no wheel encoders exist), record it per
    tick, replay it in Sim mode, serve it over the frame API, and show it
    in the GUI.
    - PositionEstimator: v = K_V*(L+R)/2, heading from IMU yaw, integrated
    x += v*cos(theta)*dt, y += v*sin(theta)*dt. ROBOT_MAX_SPEED_MPS is a
    guess to calibrate on the robot; pure spins don't translate.
    - CSV: new pos_x/pos_y/heading columns. FIELDNAMES split into
    CORE_FIELDNAMES (the original 11) so SimPlayer still loads older
    recordings, which parse the new columns as 0.0.
    - GUI: top-down mini-map (trail + heading arro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
2026-07-21 Add FPS target + readout, reduce camera rate, refresh docs
    - Capture loop: extract the tick rate into a named TARGET_FPS (default
    10 Hz) with drift-compensated scheduling (wait PERIOD_MS minus the
    tick's work time) so the actual rate tracks the target instead of
    silently halving to ~work+50ms. Add a live FPS:actual/target readout
    in the header (green within 10% of target, amber below).
    - Camera: run at CAMERA_FPS (default 15, down from the sensor's 30);
    the FIFO reader keeps only the latest frame, so 30 fps just wasted
    ISP/videoconvert/FIFO bandwidth on discarded frames.
    - Docs: document the position mini-map + pos_x/pos_y/heading columns
    in README; refresh stale "20 Hz / ~10.5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
    [logots_ui.py]
2026-07-27 Add V2 architecture proposal + mrt_experience staging→action notebook
    - docs/v2_architecture/: report.md + architecture.svg — the V2 design
    proposal for Darab (reality vs. interpretation; mrt_experience + .md)
    - experiments/staging_to_action/mrt_experience.ipynb: builds mrt_experience
    as a live sliding window over Darab's frame API (get_latest_frame)
    - gitignore the large input recording under experiments/staging_to_action/raw/
2026-07-28 Add audio_on_demand feature + action API + finalized mrt_experience
    - src/audio_on_demand.py: wake word ('Hey Jarvis') -> record until silence
    -> local Gemma 4 -> validated action, served on GET :8788/latest_action.
    Live mode pulls audio from the frame API on :8787; --wav mode replays a
    recording (SIM equivalent). Tested end-to-end both ways on the Mac.
    - docs/v2_architecture/action_api.md: the manual for Or — endpoint, client
    loop, action schema, measured latencies, robot-deployment gaps.
    - experiments/audio_on_demand/: showcase notebook (real run baked in) +
    TTS scenario wavs.
    - experiments/staging_to_action_v2/: finalized mrt_experience notebook —
    1 row = 1 s (experience_i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
2026-08-16 Add voice assistant to the GUI: persistent llama-server, Piper TTS, live status
    LlamaCppBrain now runs a persistent GPU-offloaded llama-server instead of
    spawning llama-mtmd-cli per utterance, cutting latency from ~20-30s to ~1-2s
    (the reasoning trace was also disabled -- no accuracy loss on this
    schema-constrained task). Added local Piper TTS so `speak` actions are heard
    through the robot's amp, and wired the whole wake-word -> LLM -> action -> TTS
    pipeline into logots_ui.py as a background thread, so the voice assistant is
    available from a single `python src/logots_ui.py` with no separate process or
    conda env. New header indicators (LLM/MIC status) and a last-action readout
    make it visible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
2026-08-16 Make the voice assistant cross-platform: auto-select GemmaBrain on Mac
    VoiceAssistant now picks LlamaCppBrain if the Jetson's compiled llama-server
    binary is present, otherwise falls back to GemmaBrain (transformers, MPS
    backend) -- so the same code path works with real mic/speaker input on a
    MacBook, not just the Jetson. Also makes SPEAKER_DEVICE platform-aware
    (ALSA "demixer" only on Linux, system default elsewhere) and adds
    GemmaBrain.ensure_ready() so a missing torch/transformers install surfaces
    immediately at startup instead of on the first utterance. Documents the
    extra `pip install torch transformers` step needed on the Mac side.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
    [audio_on_demand.py, logots_ui.py]
2026-08-16 Document the voice assistant in README: setup, usage, and GUI status
    Adds a "Set up the voice assistant" install step (Piper voice download,
    openwakeword model download, llama.cpp/Jetson vs torch+transformers/Mac
    brain setup) and a "Voice assistant" usage section, updates the GUI overview
    diagram with the new header indicators and ACTION readout, and notes the
    NoMachine audio-redirect gotcha under Known issues.
2026-09-03 Fix servo twitch by moving I2C message parsing out of the ISR
    sscanf/Serial.print ran inside receiveEvent(), blocking global
    interrupts long enough to occasionally delay Timer1's compare-match
    interrupt that Servo relies on to end a pulse, stretching it and
    causing a random small pan/tilt twitch even with unchanged targets.
    The ISR now only buffers bytes; parsing happens in loop().
    [logots_motor_control.ino]
2026-09-03 Document the servo twitch fix in CLAUDE.md Known issues
    Records the root cause (Serial/sscanf inside the I2C onReceive ISR
    blocking Servo's Timer1) and the fix in c36d94e for future reference.
2026-09-07 Add initiation: cold-start onboarding — survey the room, learn the plants, write knowledge/
    - src/initiation.py: reads knowledge/ (empty on first run) -> Gemma decides
    'initiation' from the guidelines rule -> publishes it on :8788 -> collects
    one survey pass from the frame API (1 fps frames + pose) -> identifies the
    plants -> writes roster, plants/, species/, room_map, journal, current_state.
    - Brain auto-select mirrors the GUI voice assistant: llama.cpp/E2B when the
    llama-server binary exists (the robot), else transformers/E4B. The llama.cpp
    vision variant lives here (imports LlamaCppBrain untouched, adds images).
    - knowledge/guidelines.md (the robot's rules, incl. the initiatio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
2026-09-08 Add --no-catalog flag: test species identification with/without the catalog
    Tested on the correct recording (session_20260903_101226, one spider plant):
    - catalog on (default): "spider plant, confidence high" — reproducible across runs
    - catalog off (--no-catalog): "unknown, confidence low" even when the prompt
    demands a committed guess — the catalog is what makes quantized E2B commit
    The identify prompt now adapts to the mode (no dangling "SPECIES CATALOG below"
    reference when the catalog is off or the file is missing), and the run log
    prints which mode is active.
2026-09-13 Move GUI status bar into a left sidebar; test initiation on real robot
    - src/logots_ui.py: the bottom status bar (motor/servo readouts, POS/SIM/
    REC/STOP controls, LOOP checkbox, keyboard hint) is now a left-hand
    column instead of a full-width strip. The four main panels keep their
    original 2x2 grid and height, unchanged.
    - initiation_test_report_20260913.txt: writeup of the first live-robot
    test of Asaph's initiation feature (catalog and --no-catalog modes),
    both correctly identifying a real snake plant end to end.
    - Remove Cat Sitter Data Architecture V2.txt and PLAN_llamacpp_gpu_offload.md
    (no longer needed).
    Claude-Sess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
    [logots_ui.py]
2026-09-13 SIM %-progress readout, IMU label overflow fix, full day's findings writeup
    - src/logots_ui.py:
    - SIM mode's status readout is now a 0-100% progress through the current
    playback pass (resets to 0% on loop wrap), replacing an uninformative
    row counter that never reset across loops.
    - Fixed the IMU panel's Yaw label getting cut off by Pitch: dropped
    unnecessary manual colon-alignment padding (the three labels are
    side-by-side chips, not stacked, so it only wasted width), tightened
    internal label padding, and simplified the numeric format.
    - initiation_test_report_20260913.txt: rewritten as a full recap of
    today's initiation-feature testing (5 --no-catalog runs across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
    [logots_ui.py]
2026-09-15 Add the functions layer: LLM-driven action loops with an enforced contract
    A function (initiation; watering next) is now a loop: prompt Gemma → one
    action → wait for completion → append the result → prompt again, until
    finish. Code maps 1:1 to the architecture diagram boxes:
    - src/functions.py loop engine + initiation + trigger (entry point)
    - src/mrt_experience.py the mart: last_row (backs inspect_plant), collect_pass
    - src/mrt_reflective.py brains + constrained-decoding ask (schema enforced)
    - src/actions.py contract v2: parsed from knowledge/actions.md
    - src/knowledge.py memory read/write
    - src/initiation.py retired — replaced by the loop
    The action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
    [actions.py, functions.py, knowledge.py, mrt_experience.py, mrt_reflective.py]
2026-09-15 Wire up functions-layer actuation; fix motor direction and llama-server reuse
    ActionReader in logots_ui.py now closes the loop on Asaf's functions.py
    decisions: polls :8788/latest_action, drives approach_plant on the real
    motors, and reports completion via POST :8788/action_done (the actual
    contract in actions.py). Verified working end-to-end in one live run.
    Also fixes two bugs found during today's live testing:
    - LlamaCppBrain._ensure_server() now reuses an already-running llama-server
    on :8789 instead of spawning a second GPU-loaded instance when
    functions.py's vision brain starts alongside the GUI's voice assistant.
    - Motor forward/backward was inverted on the real hardware; sign fl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
    [audio_on_demand.py, logots_ui.py]
2026-09-15 Empower the LLM: honest feedback, goal-oriented prompt, no scripts
    Per today's ticket and live findings with Or:
    - No fake completions: wait_for_done only accepts the actuator side's real
    POST /action_done; on timeout the truth ("no completion signal; position
    unchanged") enters the history. --done-wait flag for shorter test timeouts.
    - Goal-oriented prompt chaining: every decision carries a "thought"
    (schema-enforced, generated first) passed to the next step; history lines
    hold thought + result. Step budget visible ("step N of 12").
    - inspect (renamed from inspect_plant, no args): fetches the newest mart row
    AND returns a classification (observation, species guess, confidence) in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
    [actions.py, functions.py, knowledge.py]
2026-09-15 Fix action_id collision across functions.py restarts; add --speak thought narration
    Live-tested Asaf's goal-oriented-prompt-chaining patch on the real robot with Or
    today. Found that ActionsEndpoint._next_id started at 1 every functions.py
    process, colliding with ActionReader's long-lived _seen_id dedup in the GUI and
    silently dropping actuation on repeat runs (looked like a 120s hang, wasn't).
    Fixed by seeding _next_id from wall-clock ms instead. Also added an opt-in
    --speak flag that narrates each step's "thought" aloud via the existing
    Piper/"demixer" TTS path, for watching a run live. Verified end-to-end: repeat
    runs on the same GUI now complete approach_plant without timing out, and a f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
    [actions.py, functions.py]
2026-10-03 Encoder read-back, M1/M4 motors, front-centered pan
    Firmware:
    - Motors moved to M1 (right) / M4 (left) after rewiring.
    - Calibration block at the top: per-motor direction, per-encoder count
    direction, pan center/direction. Encoder signs set from a hand-turn
    test (left +1, right -1); motor directions and pan still default.
    - Encoders on A0-A3 decoded by a pin-change ISR (4x quadrature).
    Cumulative counts are returned on a 10-byte I2C read from 0x08:
    [0xE5][int32 left][int32 right][sum8], little-endian.
    - Pan is signed on the wire: -90..+90, 0 = front, + = left. Camera
    faces front at power-up (pan horn re-seated so servo 90 = front).
    - Serial prints ENC L= R= every 500 ms while count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
2026-10-03 CLAUDE.md: record bench calibration status for the Jetson session
    Encoder signs confirmed after reflash; motor directions and pan are the
    next checks on the Jetson. Adds the stiff-right-motor checks and the
    counts-per-revolution measurement needed for task 2.
2026-10-03 Encoder-based position estimation, straight-line trim, GUI map/perf fixes
    Bench calibration (2026-10-03 session, Jetson):
    - Motor direction fixed in hardware (right motor connector leads swapped)
    rather than firmware/software, after a bench W-test showed it reversed.
    - Pan confirmed correct (0=front, +45=left) against firmware defaults.
    - Stiff right motor quantified via direct I2C bench script: min starting
    PWM 65 both wheels, speed ratio 0.958 at PWM150 (roughly matched) -- no
    real no-load asymmetry found; later floor-load testing told a different
    story (see below).
    - Counts-per-revolution measured: left 3286, right 3208 (hand-turn test).
    PositionEstimator now uses real wheel enco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
    [logots_ui.py]
2026-10-03 CLAUDE.md: add note for Asaph on today's position/speed/straight-drive changes
    Summarizes what changed today that's relevant to the LLM/functions layer:
    pos_x/pos_y are now real metric distance (encoder-based, ~2% validated,
    not the old uncalibrated PWM guess), reference numbers for converting a
    target distance into left_pwm/right_pwm/duration_s (~0.16-0.17 m/s at
    PWM150, ~65 minimum PWM to move at all), and that equal-PWM driving now
    actually tracks straight (gyro-assisted trim) rather than just being
    documented as straight. No API/contract changes -- :8787 and :8788 are
    unchanged, this is a heads-up on data trustworthiness, not a breaking
    change.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
2026-10-05 Ground approach_plant in measured physics: stiction floor and real speed
    From Or's 2026-10-03 encoder calibration: PWM < ~65 moves nothing (silent
    no-op), PWM 150 ≈ 0.165 m/s on real floor — so the LLM can convert target
    metres into PWM + duration instead of guessing.
2026-10-05 Modular prompt files + voice mode: "Hey Jarvis" → one contract action
    - knowledge/identity.md (who the robot is) and knowledge/functions/initiation.md
    (the function's goal) move prompt text out of Python; every prompt is now an
    assembly of authored files. actions.md declares each action's exact output
    JSON, so formats live with the actions.
    - Voice mode: python src/functions.py --listen (--wav for replay testing).
    Wake word → utterance audio joins identity + the 4-action contract → one
    schema-enforced action JSON (broken JSON ungeneratable); only speak's text
    goes to the speaker. A question can trigger a real inspect: the robot looks
    and speaks its observation.
    - mrt_refl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
    [functions.py, knowledge.py, mrt_reflective.py]
2026-10-10 Fix voice silence detection; add VOICE_ASSISTANT=0; PR #6 live test report
    - Ears (audio_on_demand.py): the I2S mic's baseline drifts at ~1-3 Hz, which
    read as RMS ~150 with spikes past 400 and kept resetting the fixed
    SILENCE_RMS=300 countdown, so captures ran 8-21 s and merged requests.
    High-pass at 100 Hz before the RMS check (silence ~4, speech 20-170),
    SILENCE_RMS 300 -> 15, and only start the silence countdown once speech
    has begun (NO_SPEECH_S=4 s if it never does). Captures now end ~1 s after
    speech: 3-6 s, one request each.
    - logots_ui.py: VOICE_ASSISTANT=0 skips the built-in voice assistant, so it
    doesn't answer "Hey Jarvis" alongside functions.py --listen.
    - docs/tes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
    [audio_on_demand.py, logots_ui.py]
2026-10-19 Fix voice message layout (system/user split) and approach persistence
    1. Voice: the identity+actions prompt was packed WITH the utterance audio
    into one user message, so Gemma conversed with its own briefing instead
    of acting on the request (Or's A/B: 1/4 vs 4/4). The prompt now rides as
    a system message; the person's audio is the user turn. Reproduced and
    verified locally: same "come closer" clip flipped from
    speak("Hello. I am Logots...") to approach_plant(...).
    2. Persistence: the anti-repeat rule that killed the inspect loop also made
    the robot give up after one 30cm drive from 2.5m away. The rule now
    judges by measured results — repeat while your position/view ch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
2026-10-20 Scrap the legacy voice module: one listener, functions.py --listen
    Removed (agreed Or+Asaph, 2026-10-20): VoiceAssistant thread + MIC/LLM
    header indicators + ACTION row from logots_ui.py; the v1 action list,
    BRAIN_PROMPT, decide() paths, GemmaBrain/MockBrain, ActionServer and the
    standalone main from audio_on_demand.py. That module now holds only shared
    plumbing: Ears, llama-server management, speak()/Piper, audio sources.
    383 lines deleted, 6 added. Regression-tested: functions.py --listen still
    answers the "come closer" clip with approach_plant.
2026-10-31 Document the Berlin setup as a new-Jetson checklist; save robot #1's system files
    Robot #1 now lives at Asaph's home in Berlin. CLAUDE.md gets a "New Jetson setup" section
    recapping what made its desktop usable over NoMachine (WiFi via nmcli, polkit rules for the
    WiFi icon and Shut Down button, blank login-keyring password for Chromium, NoMachine by
    hostname), written to repeat on robot #2.
    docs/robot1_system/ keeps the two files that only existed on robot #1's disk: the known-good
    jetson-io 40-pin screenshot and the custom "demixer" ALSA block (not the full asound.conf,
    whose rest is NVIDIA's licensed stock file).
2026-10-31 Restore _piper_voice global: voice replies have been silent since 1af9463
    The legacy-voice cleanup deleted the module-level `_piper_voice = None` while
    keeping _get_piper_voice(), so every speak() raised NameError. speak() swallows
    errors by design, printing only "[mouth] speak failed", so functions.py --listen
    and --speak still decided and drove but said nothing.
    Tested: functions.py --listen --wav now loads Piper and plays a spoken reply
    with no error.
2026-10-31 GUI starts the voice listener again and shows its status, as separate processes
    PR #7 moved voice out of the GUI into functions.py --listen, which was the right
    architecture, but lost two things with it: one-command startup, and the LLM/MIC
    indicators + ACTION row. This restores both without merging the processes.
    Listener -> GUI: new GET :8788/status {stage, last_action}, polled by
    ListenerStatusReader in its own thread. Stages: off, loading, asleep, listening,
    thinking, acting, speaking. The GUI adds "error" itself when its listener has exited.
    GUI -> listener: logots_ui.py launches `functions.py --listen` as a subprocess.
    OFF, window close and SIGTERM share _shutdown(): flush recording,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
2026-10-31 CLAUDE.md: describe the current voice setup; drop what PR #7 removed
    The doc still described the in-process VoiceAssistant, VOICE_ASSISTANT, GemmaBrain and
    the torch/transformers Mac path, all deleted in PR #7. It now covers the two-process
    setup: GUI starts the listener, /status, LISTEN=0, shutdown, the known gap after a
    force-kill, and that voice needs the llama.cpp path because VisionBrain ignores audio.
    Known issues gains the live robot test still to do and the silent-speech regression,
    with the lesson that a correct decision doesn't prove the robot spoke. Test recipes now
    say to use LISTEN=0.
2026-10-31 Listener runs initiation at launch when no plants are known
    The empty-roster check only ran on a plain functions.py, and --listen skipped it, so a
    robot with no documents never initiated on its own. The listener now checks the roster
    once the model has loaded: if it's empty, it announces it, runs initiation, then listens.
    It stays in one process, so there's no :8788 conflict.
    Skipped when plants are known, during Sim (a recording's plants don't belong in this
    robot's memory), with no camera frame after 20 s, and with --wav. A failed initiation
    doesn't stop the listener; the roster stays empty, so the next launch tries again. The
    GUI shows MIC: initiation, and the ACTION row follows each ste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
